aleesposito85/openwindow/docs/plans/2026-10-11-soft-edges.md

# OpenWindow Soft Edges Implementation Plan

> **For agentic workers:** REQUIRED SUB-SKILL: Use superpowers:subagent-driven-development (recommended) or superpowers:executing-plans to implement this plan task-by-task. Steps use checkbox (`- [ ]`) syntax for tracking.

**Goal:** Round every printed profile's outside edges to 2 mm, bevel every joint by 0.8 mm, and soften the hand-touched parts. Seals, glazing, tubes, joints and fixings keep their exact shape.

**Architecture:**
- **Profile rounding.**
  - `cad/profile.scad` builds each profile from a list of base rectangles (or the sill polygon). It rounds them with `soften()` (shrink by `EDGE_R`, grow back with radius `EDGE_R`) before subtracting any functional cut.
  - A short per-profile table, `sharp_corners()`, adds back the corners where a cut ends too close to keep a 1.5 mm wall.
  - A new CAD test finds every convex corner automatically, samples its 2 mm arc and checks the distance to every cut, so the table can't go stale.
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
