aleesposito85/openwindow/docs/img/deck/corner.png

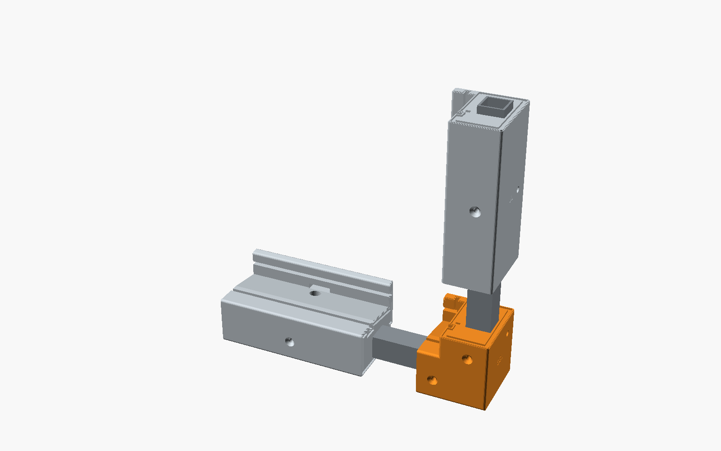
docs/img/deck/corner.png
