aleesposito85/openwindow/docs/img/deck/hero-bench.png

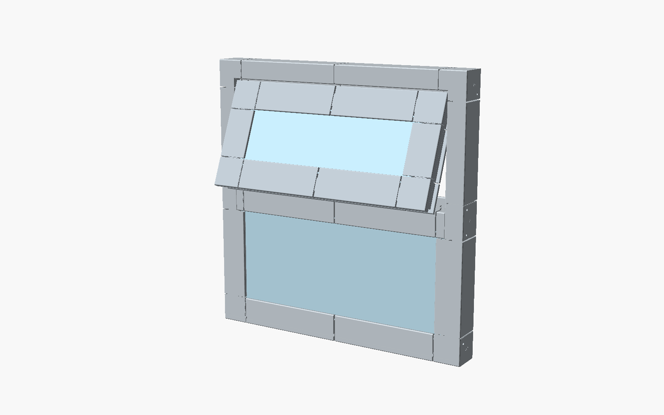
docs/img/deck/hero-bench.png
