aleesposito85/openwindow/docs/img/deck/hinge.png

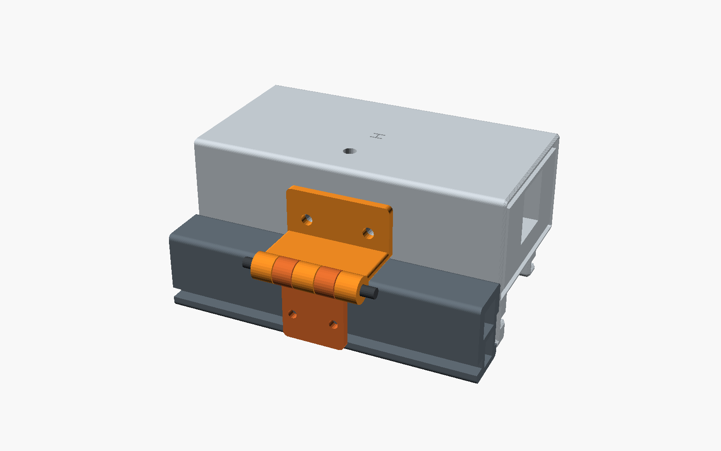
docs/img/deck/hinge.png
