aleesposito85/openwindow/docs/img/deck/inside-open.png

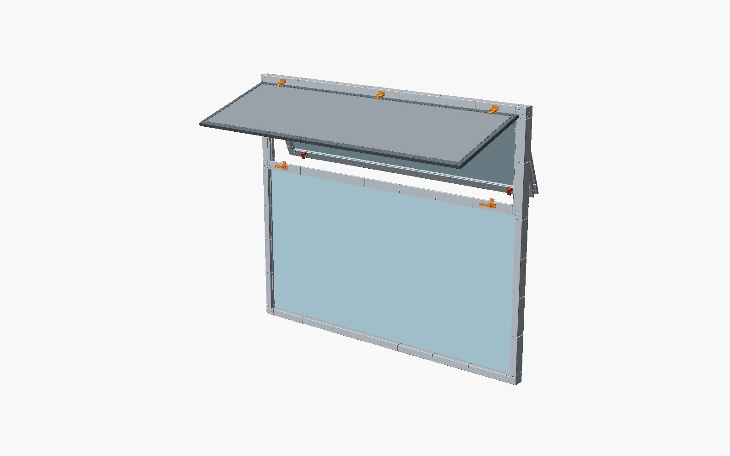
docs/img/deck/inside-open.png
