aleesposito85/openwindow/docs/img/deck/joint.png

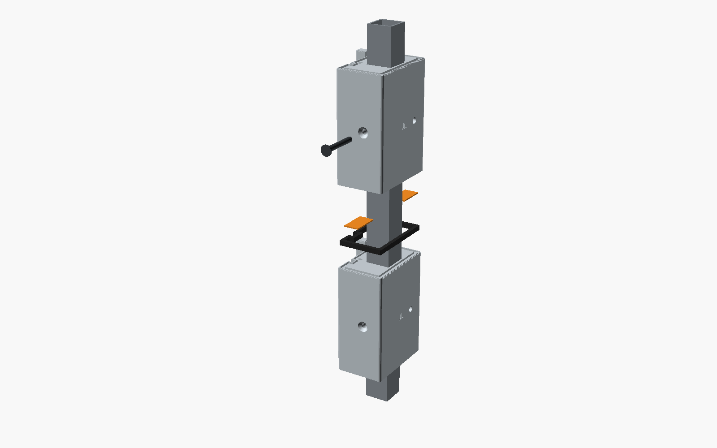
docs/img/deck/joint.png
