aleesposito85/openwindow/docs/img/deck/node.png

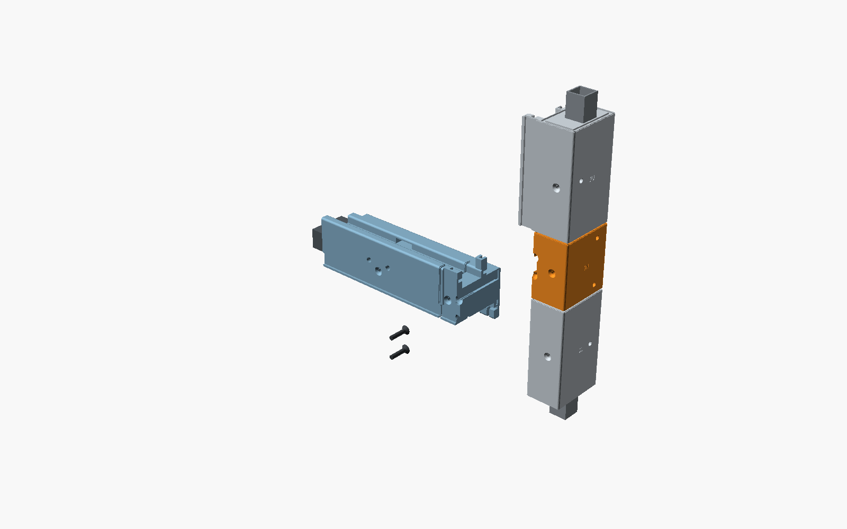
docs/img/deck/node.png
