aleesposito85/openwindow/docs/img/deck/part-AC.png

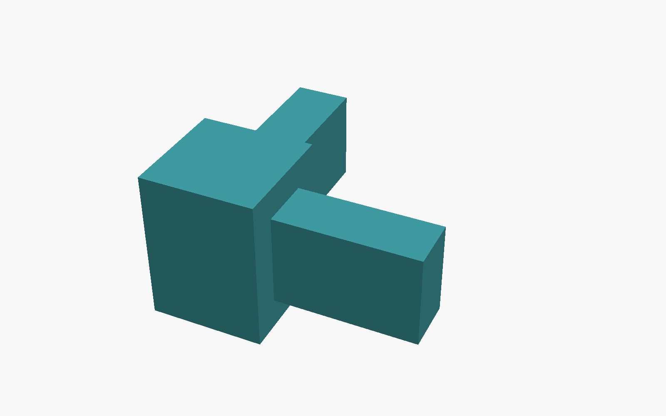
docs/img/deck/part-AC.png
