aleesposito85/openwindow/docs/img/deck/part-AFH.png

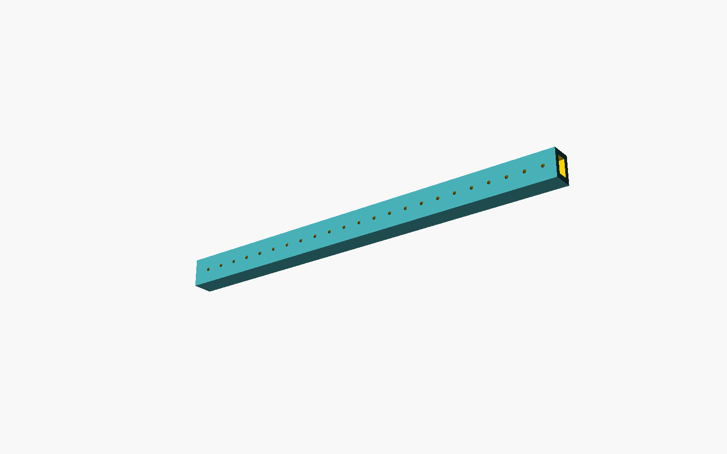
docs/img/deck/part-AFH.png
