aleesposito85/openwindow/docs/img/deck/part-CH.png

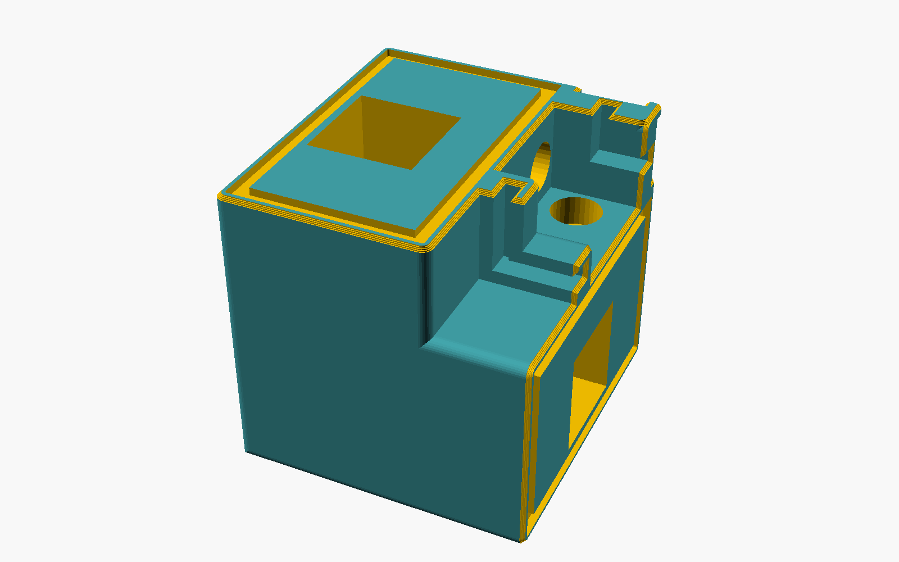
docs/img/deck/part-CH.png
