aleesposito85/openwindow/docs/img/deck/part-CMB.png

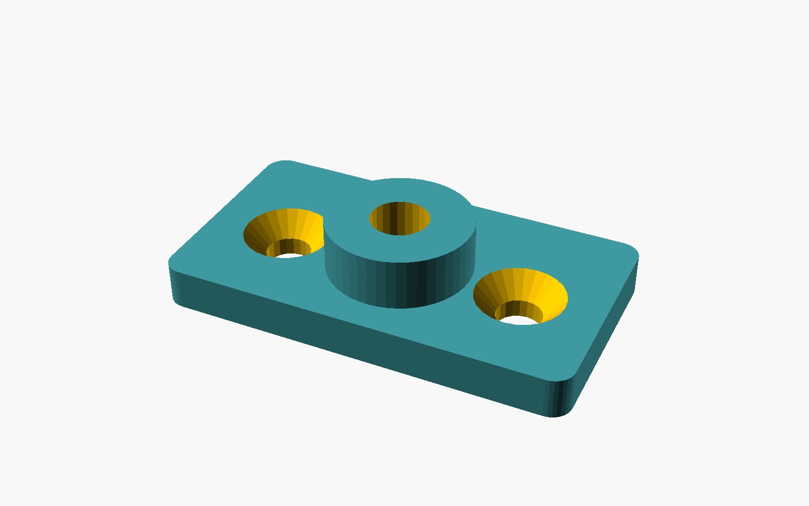
docs/img/deck/part-CMB.png
