aleesposito85/openwindow/docs/img/deck/part-CMH.png

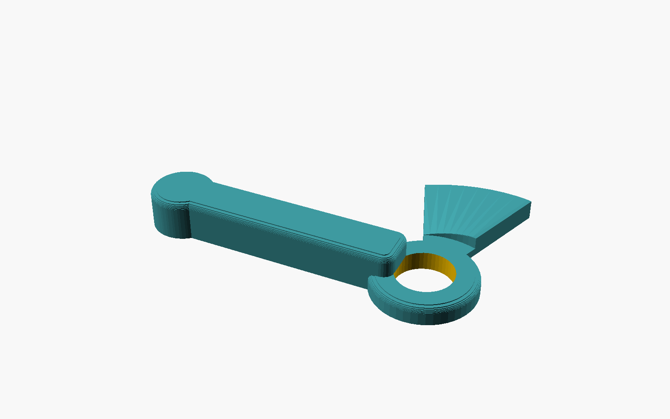
docs/img/deck/part-CMH.png
