aleesposito85/openwindow/docs/img/deck/part-CN.png

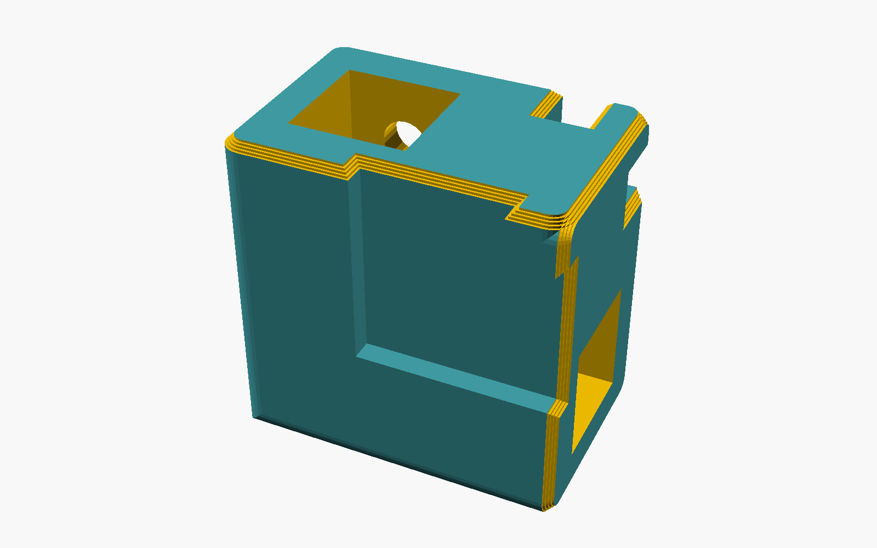
docs/img/deck/part-CN.png
