aleesposito85/openwindow/docs/img/deck/part-CS.png

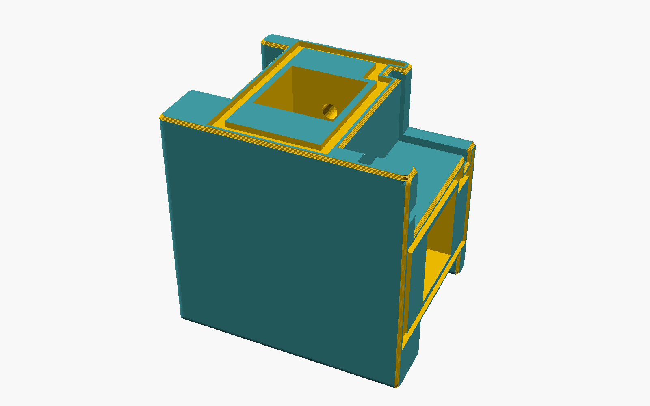
docs/img/deck/part-CS.png
