aleesposito85/openwindow/docs/img/deck/part-CSR.png

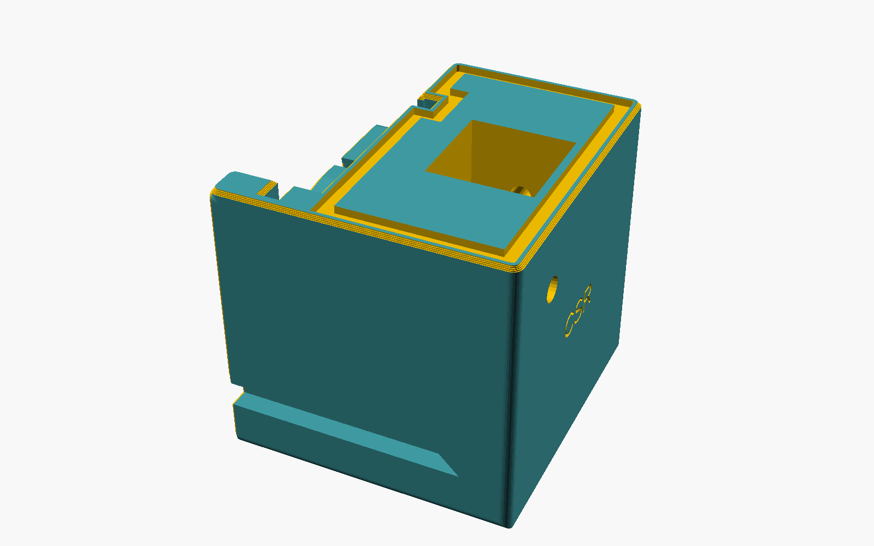
docs/img/deck/part-CSR.png
