aleesposito85/openwindow/docs/img/deck/part-GF.png

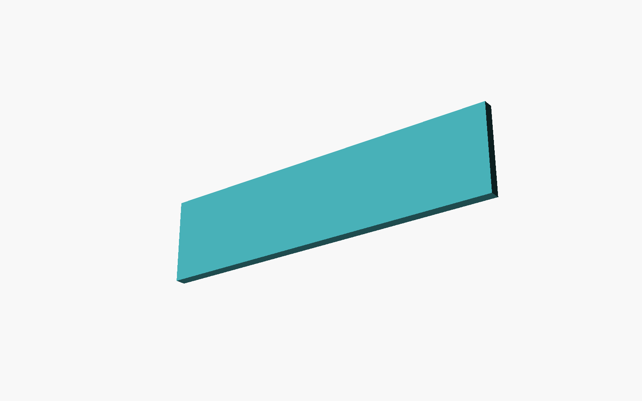
docs/img/deck/part-GF.png
