aleesposito85/openwindow/docs/img/deck/part-H.png

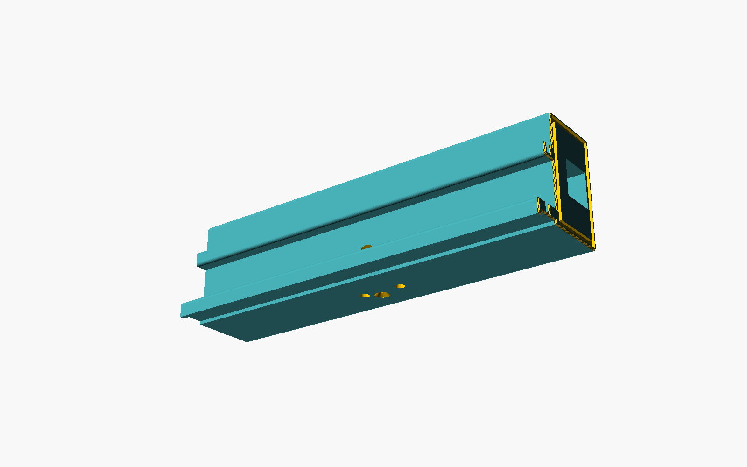
docs/img/deck/part-H.png
