aleesposito85/openwindow/docs/img/deck/part-HG.png

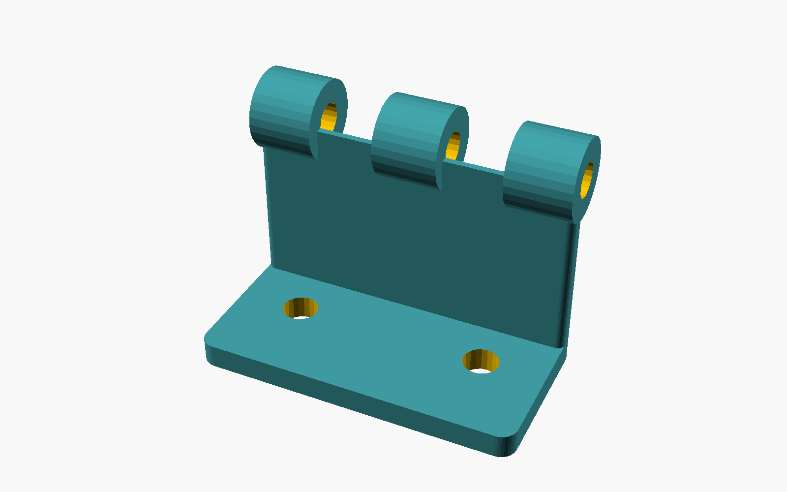
docs/img/deck/part-HG.png
