aleesposito85/openwindow/docs/img/deck/part-HS.png

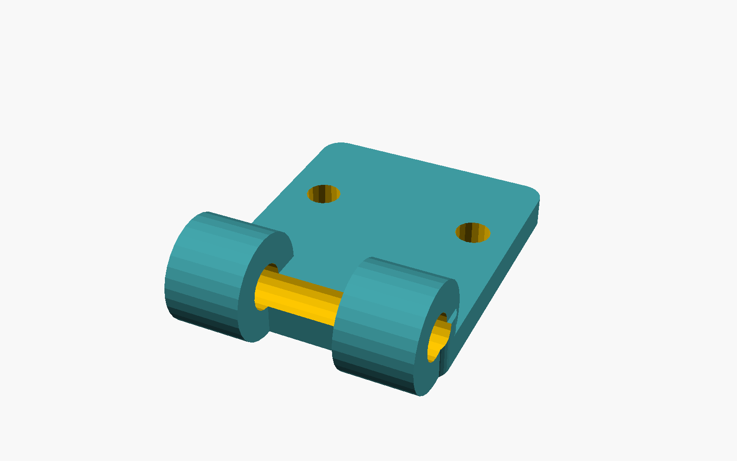
docs/img/deck/part-HS.png
