aleesposito85/openwindow/docs/img/deck/part-JN.png

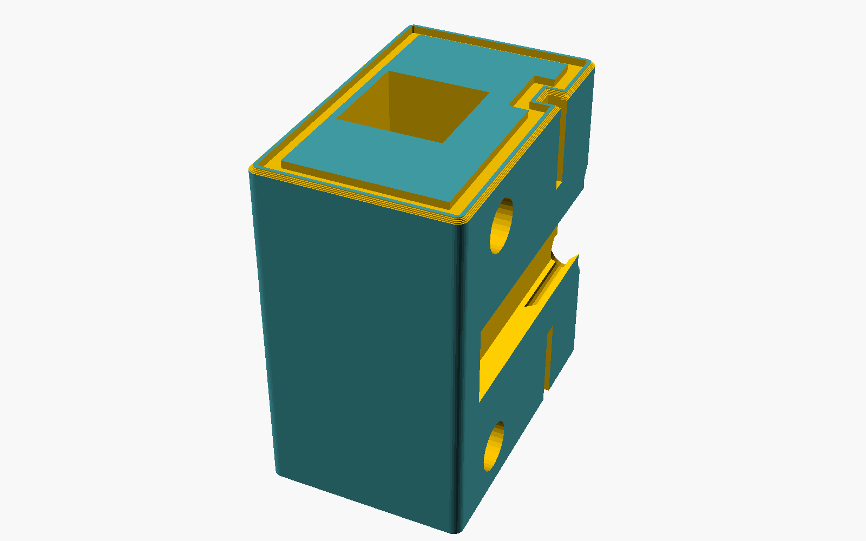
docs/img/deck/part-JN.png
