aleesposito85/openwindow/docs/img/deck/part-KP.png

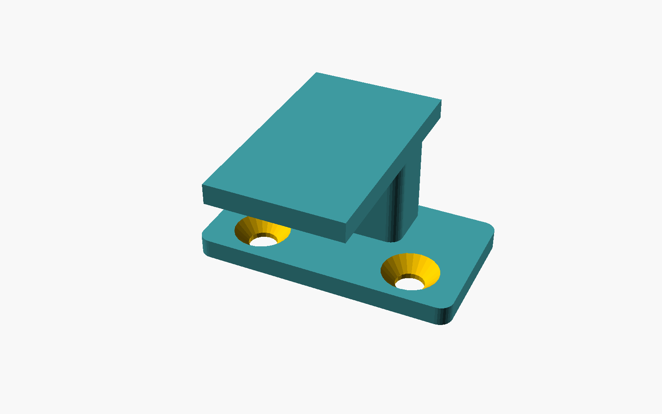
docs/img/deck/part-KP.png
