aleesposito85/openwindow/docs/img/deck/part-TC.png

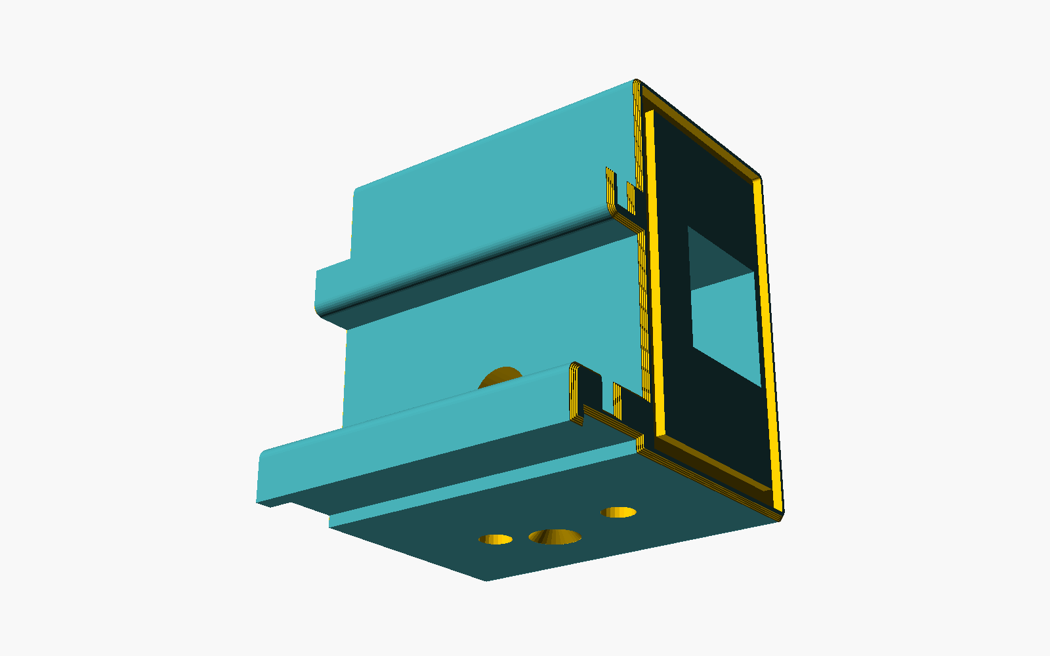
docs/img/deck/part-TC.png
