aleesposito85/openwindow/docs/img/deck/part-TSL.png

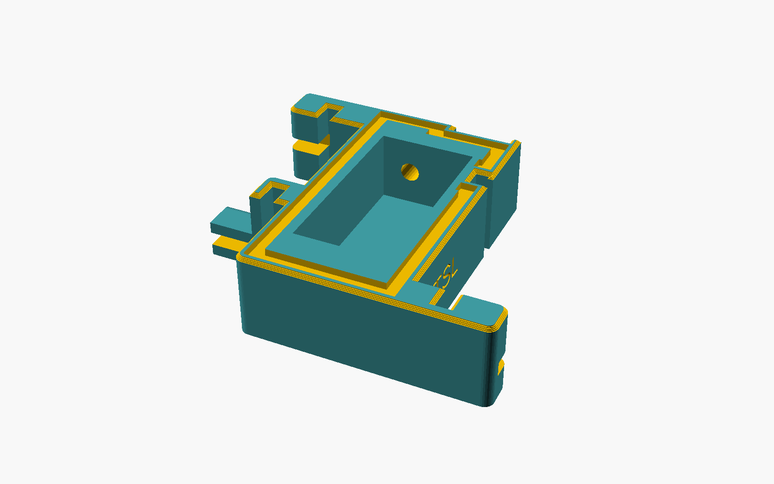
docs/img/deck/part-TSL.png
