aleesposito85/openwindow/docs/img/deck/part-TSR.png

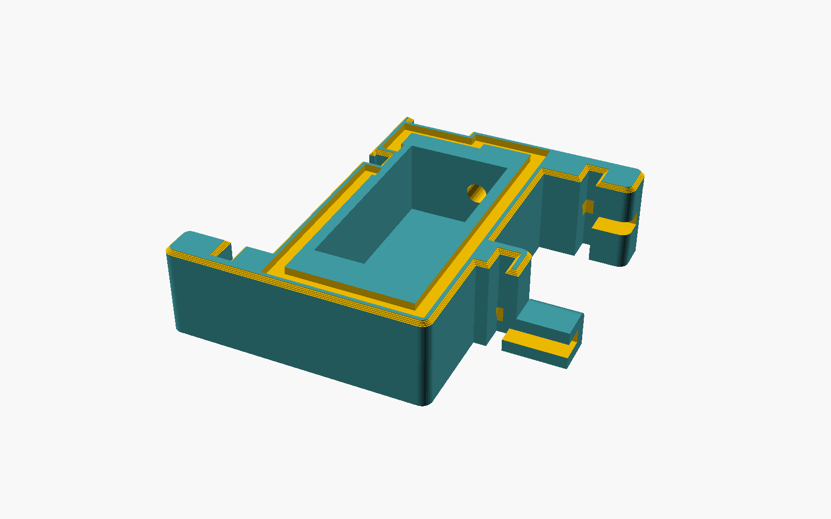
docs/img/deck/part-TSR.png
