aleesposito85/openwindow/docs/img/deck/profile-0.png

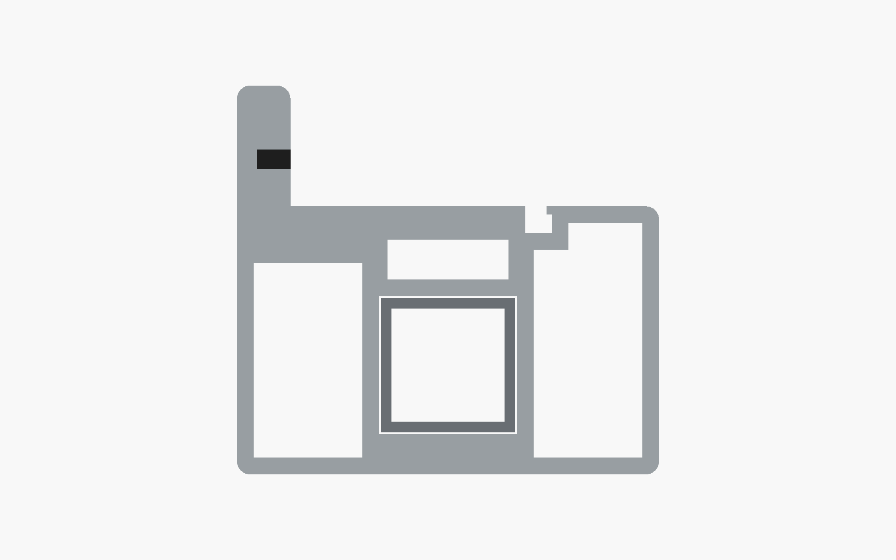
docs/img/deck/profile-0.png
