aleesposito85/openwindow/docs/img/deck/profile-1.png

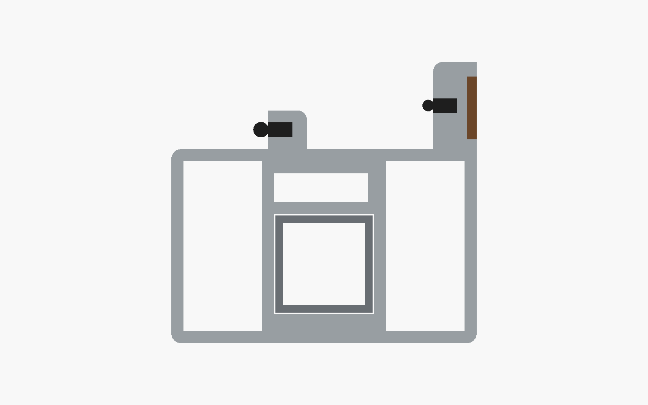
docs/img/deck/profile-1.png
