aleesposito85/openwindow/docs/img/deck/profile-2.png

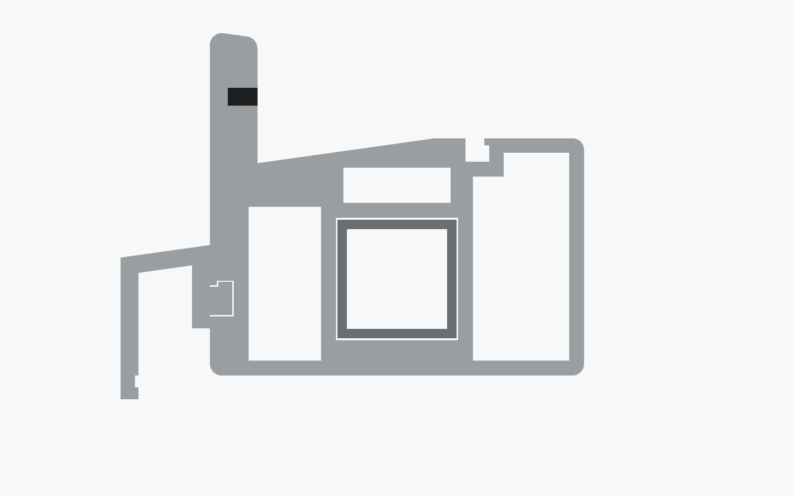
docs/img/deck/profile-2.png
