aleesposito85/openwindow/docs/img/deck/profile-3.png

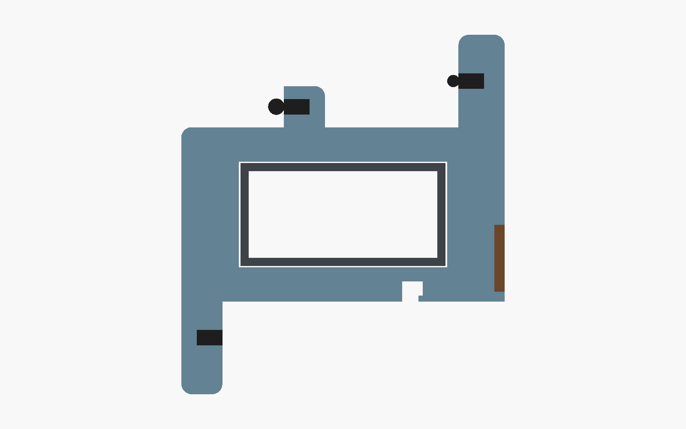
docs/img/deck/profile-3.png
