aleesposito85/openwindow/docs/img/deck/profile-4.png

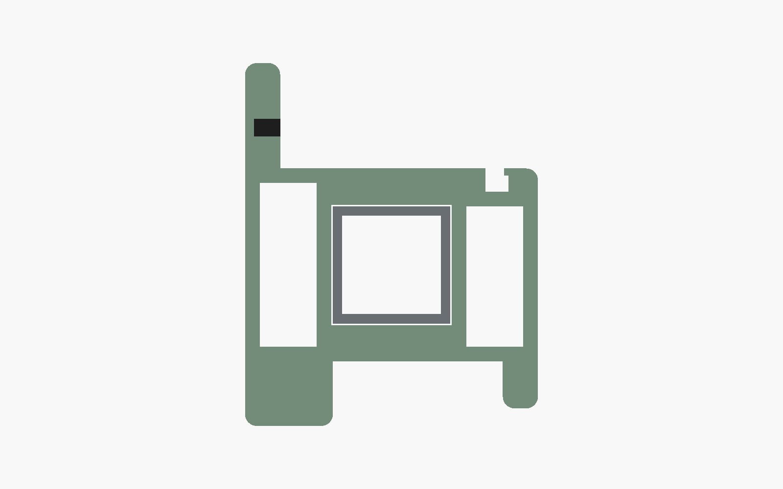
docs/img/deck/profile-4.png
