aleesposito85/openwindow/docs/img/deck/profile-5.png

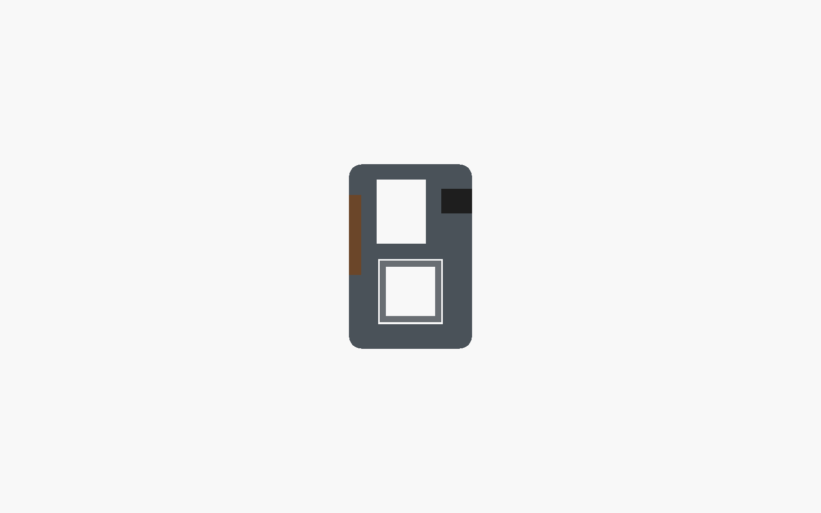
docs/img/deck/profile-5.png
