aleesposito85/openwindow/docs/img/deck/profile-6.png

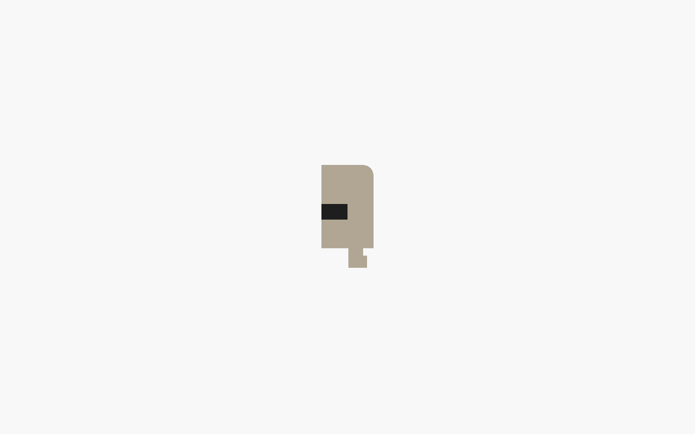
docs/img/deck/profile-6.png
