aleesposito85/openwindow/docs/img/deck/section-0.png

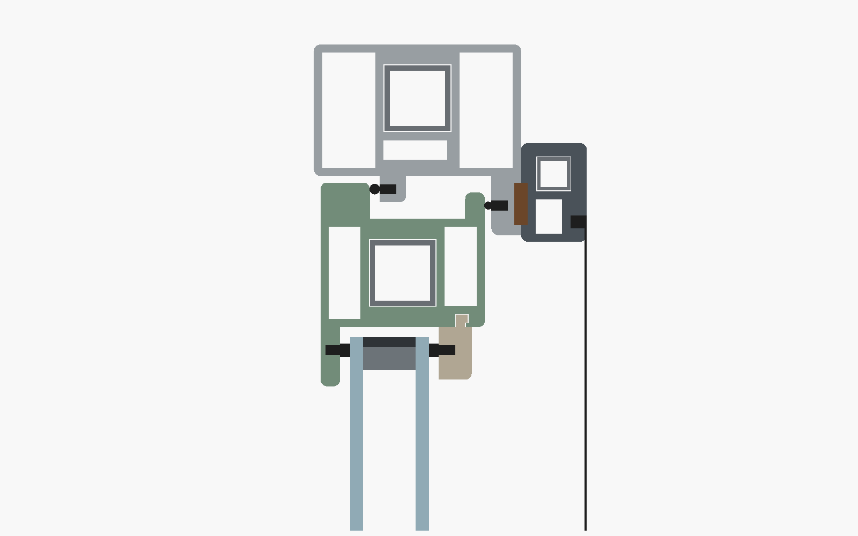
docs/img/deck/section-0.png
