aleesposito85/openwindow/docs/img/deck/section-2.png

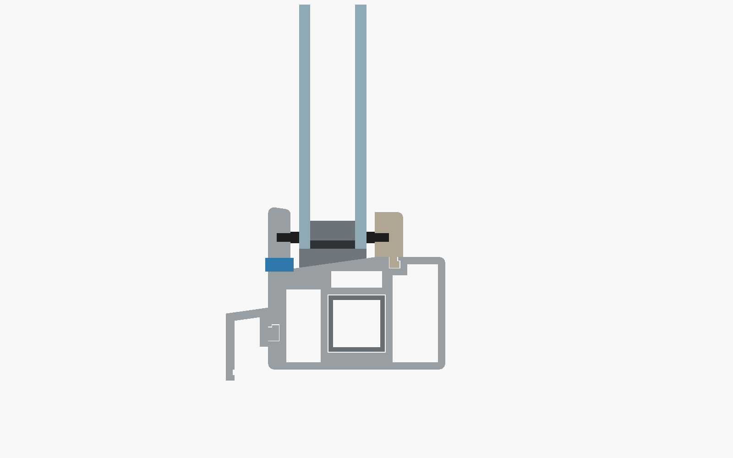
docs/img/deck/section-2.png
