aleesposito85/openwindow/docs/img/deck/section-3.png

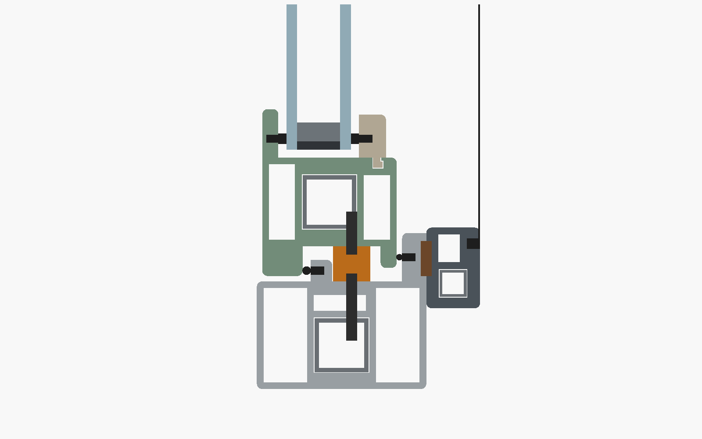
docs/img/deck/section-3.png
