aleesposito85/openwindow/docs/img/deck/sill-detail.png

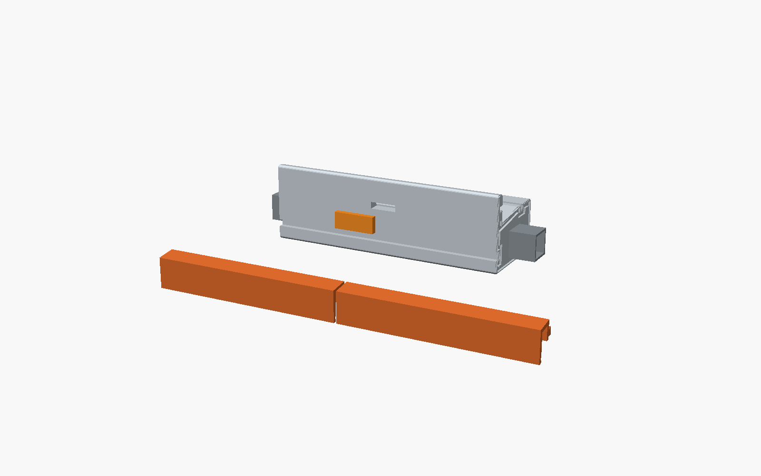
docs/img/deck/sill-detail.png
