aleesposito85/openwindow/docs/img/deck/unit-0.png

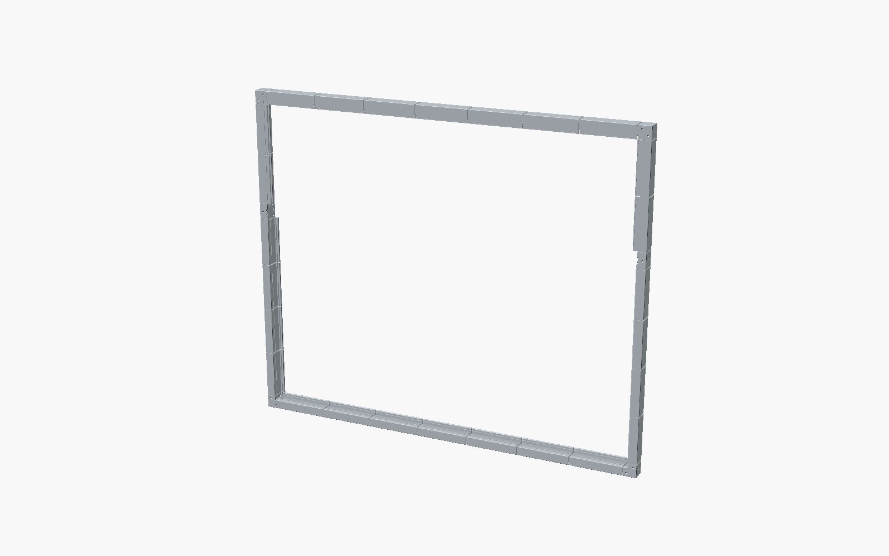
docs/img/deck/unit-0.png
