aleesposito85/openwindow/docs/img/deck/unit-1.png

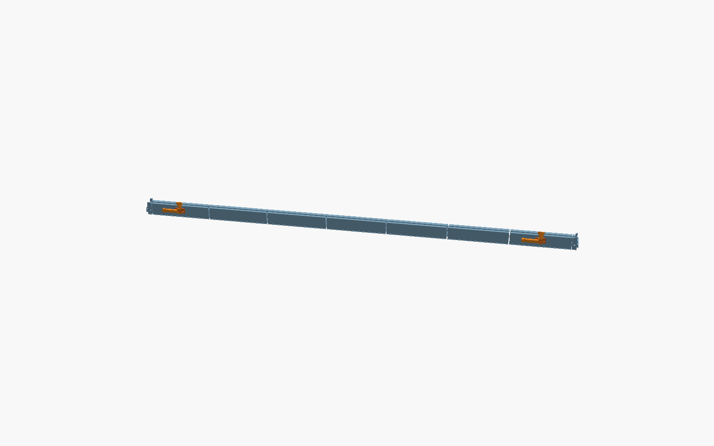
docs/img/deck/unit-1.png
