aleesposito85/openwindow/docs/img/deck/unit-2.png

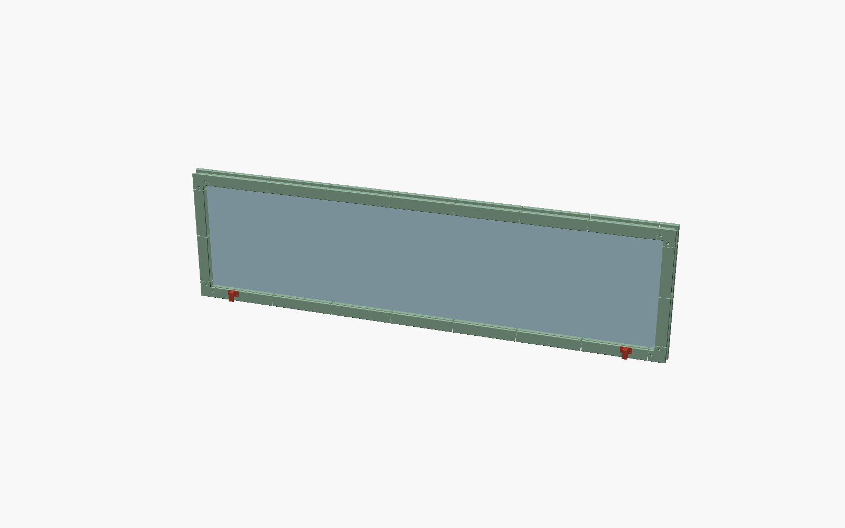
docs/img/deck/unit-2.png
