aleesposito85/openwindow/docs/img/deck/unit-4.png

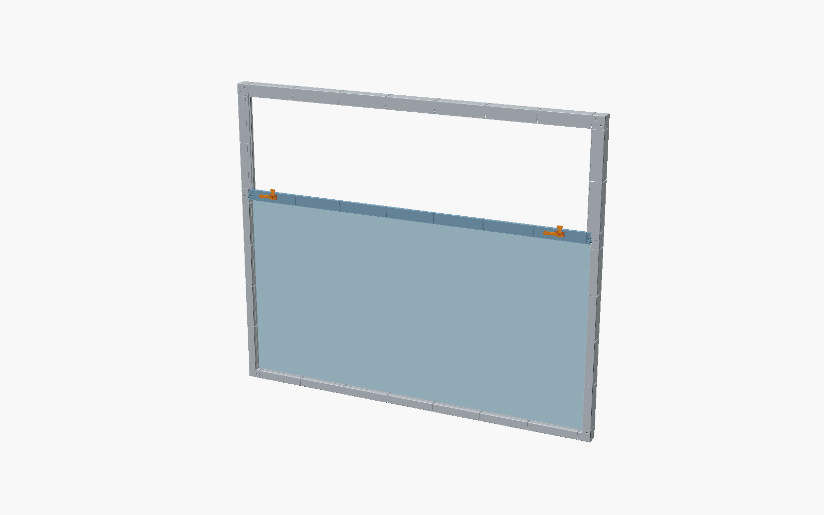
docs/img/deck/unit-4.png
