aleesposito85/openwindow/docs/img/fit_view.png

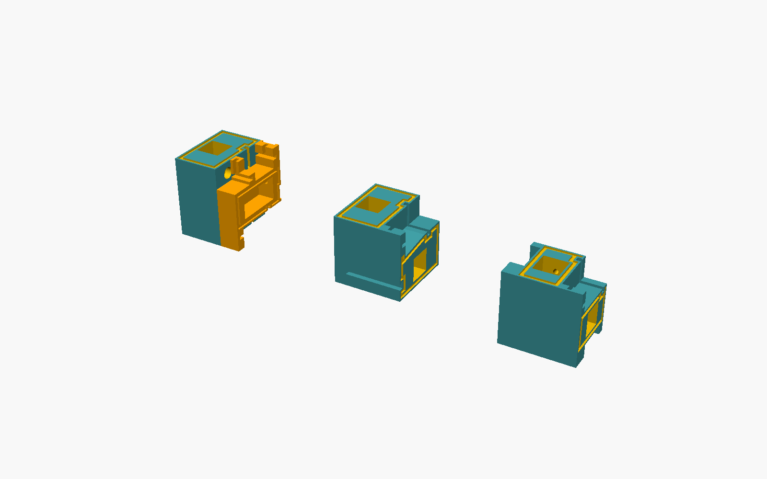
docs/img/fit_view.png
