aleesposito85/openwindow/docs/img/lock_view.png

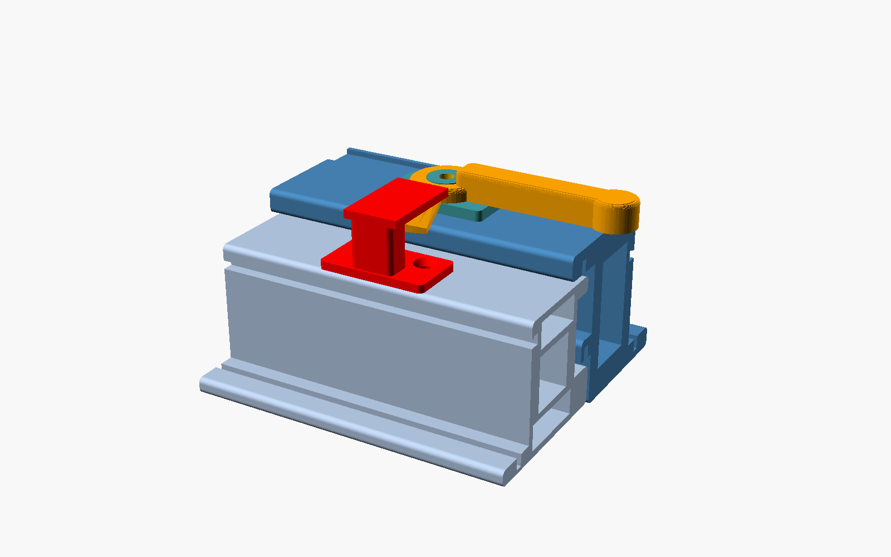
docs/img/lock_view.png
