aleesposito85/openwindow/docs/img/section-home.png

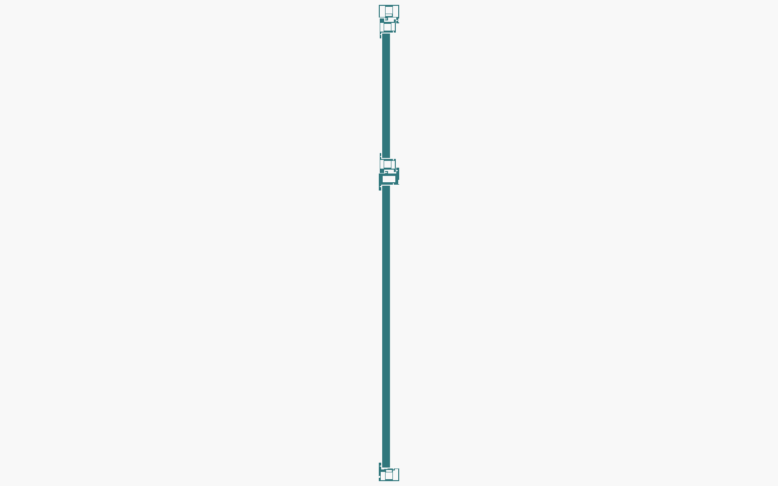
docs/img/section-home.png
