aleesposito85/openwindow/bom/home-1800x1500.md

# BOM: home-1800x1500

Prints: 160 parts in 35 types (list: `bom/home-1800x1500-parts.csv`).

| Group | Item | Qty | Unit |
|---|---|---|---|
| Fixings | Timber screw 10g x 75, stainless or galvanised (frame fixings) | 38 | pcs |
| Fixings | Self-tapping screw 8g x 30 stainless, countersunk (aluminium tube screws: frame, sash, corners, nodes) | 62 | pcs |
| Fixings | Tek screw 8g x 25, 410 stainless, countersunk (steel transom tube: T, TE, shoes) | 9 | pcs |
| Fixings | Self-tapping screw 8g x 12 stainless, countersunk (screen tube screws) | 26 | pcs |
| Fixings | M4 heat-set insert for a 5.6 x 8 mm hole | 30 | pcs |
| Fixings | M4 x 10 countersunk machine screw (cam bases CMB, keepers KP) | 8 | pcs |
| Fixings | M4 x 10 pan or button head machine screw (hinge frame leaves HG) | 6 | pcs |
| Fixings | M4 x 8 pan screw + 20 mm penny washer (cam pivots) | 2 | pcs |
| Fixings | M4 x 16 countersunk machine screw (transom lock screws) | 4 | pcs |
| Fixings | M4 x 50 bolt + nyloc nut (hinge pins) | 3 | pcs |
| Fixings | 4g x 12 self-tapping screw (screen leaves HS) | 6 | pcs |
| Fixings | Plastic window packers, assorted 1-10 mm (one stack per position) | 44 | pcs |
| Hardware | Stainless friction stay pair, 400 mm, stack <= 13 mm, track/arm width <= 14 mm (check rating >= 15.7 kg) | 1 | pair |
| Hardware | Friction-stay screw 8g x 25 stainless, countersunk (tracks to upper jambs; match the stay's holes) | 8 | pcs |
| Hardware | Friction-stay screw 8g x 16 stainless, countersunk (arms to sash sides; match the stay's holes) | 6 | pcs |
| Seals | EPDM bulb kerf seal, 3 mm kerf (outer + inner loop round the sash opening) | 8.92 | m |
| Seals | EPDM glazing wedge gasket, 3 mm | 18.28 | m |
| Seals | Closed-cell foam cord, 4 mm (one ring per segment joint) | 11.3 | m |
| Seals | Closed-cell foam cord, 3 mm (transom shoe seams) | 0.14 | m |
| Seals | MS-polymer sealant rated for +/-50% joint movement (ASTM C920 Class 50 or equal), 290 ml cartridge (joints, fixing bedding, outside perimeter) | 3 | pcs |
| Seals | Butyl flashing tape, 150 mm wide (sill tray; or two 100 mm runs lapped 50 mm) | 2.08 | m |
| Seals | Backer rod, 10 mm | 6.54 | m |
| Seals | Low-expansion window foam, can | 1 | pcs |
| Seals | Gel CA glue (EPDM loop joints) | 1 | pcs |
| Screen | Flexible magnetic strip A, 12.7 mm, adhesive-backed (screen back channel) | 4.53 | m |
| Screen | Flexible magnetic strip B, 12.7 mm, adhesive-backed, matched to A, or adhesive steel strip (frame magnet channel) | 4.53 | m |
| Screen | Fibreglass insect mesh | 1.02 | m2 |
| Screen | Screen spline, 4 mm | 4.53 | m |
| Screen | Two-part epoxy, 5-minute (screen corner joints) | 1 | pcs |
| Tube | Tube alu10 (total length; buy in 1 m/3 m stock) | 4.37 | m |
| Tube | Tube alu20 (total length; buy in 1 m/3 m stock) | 10.31 | m |
| Tube | Tube steel40x20 (total length; buy in 1 m/3 m stock) | 1.7 | m |
| Glazing | IGU 4/16/4 = 24 mm, toughened if required by AS 1288, low-E/argon optional, 1698 x 878 (fixed pane) | 1 | pcs |
| Glazing | IGU 4/16/4 = 24 mm, toughened if required by AS 1288, low-E/argon optional, 1606 x 388 (sash pane) | 1 | pcs |
| Filament | PETG (interior) | 3.84 | kg |
| Filament | ASA-CF or PC-ABS (light colour) (exterior, tier 3) | 16.36 | kg |

## Tube cut list (`bom/home-1800x1500-cutlist.csv`)

| Member | Core | Length (mm) | Qty |
|---|---|---|---|
| head | alu20 | 1721.0 | 1 |
| sill | alu20 | 1721.0 | 1 |
| jamb | alu20 | 1421.0 | 2 |
| transom | steel40x20 | 1696.0 | 1 |
| sash_horizontal | alu20 | 1615.0 | 2 |
| sash_vertical | alu20 | 397.0 | 2 |
| screen_horizontal | alu10 | 1685.0 | 2 |
| screen_vertical | alu10 | 501.0 | 2 |

## Glass (`bom/home-1800x1500-glass.csv`)

| Pane | Glazing | Width (mm) | Height (mm) | Qty |
|---|---|---|---|---|
| fixed | igu | 1698 | 878 | 1 |
| sash | igu | 1606 | 388 | 1 |
