aleesposito85/openwindow/bom/bench-600-parts.csv

id | qty | role | length | module | call
H | 2 | exterior | 232.5 | frame_segment | frame_segment("sash_rebate", 232.5, "H", bosses=true);
SW | 2 | exterior | 232.5 | frame_segment | frame_segment("sill", 232.5, "SW", weep=true);
JL | 2 | exterior | 196.0 | frame_segment | frame_segment("glazing", 196.0, "JL");
JU | 2 | exterior | 198.0 | frame_segment | frame_segment("sash_rebate", 198.0, "JU");
TE | 2 | exterior | 232.5 | frame_segment | frame_segment("transom", 232.5, "TE", weep=true, bosses=true);
SH | 2 | exterior | 186.5 | frame_segment | frame_segment("sash", 186.5, "SH");
SBE | 2 | exterior | 186.5 | frame_segment | frame_segment("sash", 186.5, "SBE", weep=true, bosses=true, boss_dz=23.0);
SV | 2 | exterior | 106.0 | frame_segment | frame_segment("sash", 106.0, "SV");
NH | 4 | interior | 232.0 | frame_segment | frame_segment("screen", 232.0, "NH");
NV | 2 | interior | 230.0 | frame_segment | frame_segment("screen", 230.0, "NV");
CH | 2 | exterior |  | corner_block | corner_block("sash_rebate", "sash_rebate", "CH");
CSL | 1 | exterior |  | corner_block | corner_block("sill", "glazing", "CSL");
CSR | 1 | exterior |  | corner_block | corner_block("sill", "glazing", "CSR", mirrored=true);
CS | 4 | exterior |  | corner_block | corner_block("sash", "sash", "CS");
CN | 4 | interior |  | corner_block | corner_block("screen", "screen", "CN");
JN | 2 | exterior |  | jamb_node | jamb_node("JN");
TSL | 1 | exterior |  | transom_shoe | transom_shoe("TSL", mirrored=true);
TSR | 1 | exterior |  | transom_shoe | transom_shoe("TSR");
GW | 2 | exterior |  | setting_block | setting_block("GW", wedge=true);
GF | 6 | exterior |  | setting_block | setting_block("GF");
WC | 4 | exterior |  | weep_cap | weep_cap("WC");
NS | 3 | exterior | 182.67 | sill_nose | sill_nose(182.67, "NS");
CMB | 2 | interior |  | cam_base | cam_base("CMB");
CMH | 2 | interior |  | cam_handle | cam_handle("CMH");
KP | 2 | interior |  | cam_keeper | cam_keeper("KP");
HG | 2 | interior |  | screen_hinge | screen_hinge("HG");
HS | 2 | interior |  | screen_leaf | screen_leaf("HS");
TC | 1 | exterior |  | test_coupon | test_coupon("TC");
BFH | 6 | interior | 168.0 | bead | bead("acrylic", 168.0, "BFH");
BFV | 2 | interior | 202.0 | bead | bead("acrylic", 202.0, "BFV");
BSH | 4 | interior | 206.0 | bead | bead("acrylic", 206.0, "BSH");
BSV | 2 | interior | 112.0 | bead | bead("acrylic", 112.0, "BSV");
AFH | 4 | exterior | 237.0 | acrylic_spacer | acrylic_spacer(237.0, "AFH");
AFV | 2 | exterior | 204.0 | acrylic_spacer | acrylic_spacer(204.0, "AFV");
ASH | 4 | exterior | 191.0 | acrylic_spacer | acrylic_spacer(191.0, "ASH");
ASV | 2 | exterior | 114.0 | acrylic_spacer | acrylic_spacer(114.0, "ASV");
AC | 8 | exterior |  | acrylic_spacer_corner | acrylic_spacer_corner("AC");
