aleesposito85/openwindow/bom/home-1800x1500-2bay-parts.csv

id | qty | role | length | module | call
H | 8 | exterior | 198.5 | frame_segment | frame_segment("sash_rebate", 198.5, "H", bosses=true);
S | 4 | exterior | 198.5 | frame_segment | frame_segment("sill", 198.5, "S");
SW | 4 | exterior | 198.5 | frame_segment | frame_segment("sill", 198.5, "SW", weep=true);
JL | 8 | exterior | 210.75 | frame_segment | frame_segment("glazing", 210.75, "JL");
JU | 4 | exterior | 223.5 | frame_segment | frame_segment("sash_rebate", 223.5, "JU");
T | 4 | exterior | 198.5 | frame_segment | frame_segment("transom", 198.5, "T");
TE | 4 | exterior | 198.5 | frame_segment | frame_segment("transom", 198.5, "TE", weep=true, bosses=true);
ML | 4 | exterior | 210.75 | frame_segment | frame_segment("mullion_glazing", 210.75, "ML");
MU | 2 | exterior | 223.5 | frame_segment | frame_segment("mullion_sash", 223.5, "MU");
SH | 6 | exterior | 234.33 | frame_segment | frame_segment("sash", 234.33, "SH");
SB | 2 | exterior | 234.33 | frame_segment | frame_segment("sash", 234.33, "SB");
SBE | 4 | exterior | 234.33 | frame_segment | frame_segment("sash", 234.33, "SBE", weep=true, bosses=true, boss_dz=63.92);
SV | 8 | exterior | 177.5 | frame_segment | frame_segment("sash", 177.5, "SV");
NH | 16 | interior | 198.75 | frame_segment | frame_segment("screen", 198.75, "NH");
NV | 8 | interior | 240.0 | frame_segment | frame_segment("screen", 240.0, "NV");
CH | 2 | exterior |  | corner_block | corner_block("sash_rebate", "sash_rebate", "CH");
CSL | 1 | exterior |  | corner_block | corner_block("sill", "glazing", "CSL");
CSR | 1 | exterior |  | corner_block | corner_block("sill", "glazing", "CSR", mirrored=true);
CS | 8 | exterior |  | corner_block | corner_block("sash", "sash", "CS");
CN | 8 | interior |  | corner_block | corner_block("screen", "screen", "CN");
JN | 2 | exterior |  | jamb_node | jamb_node("JN");
TSL | 1 | exterior |  | transom_shoe | transom_shoe("TSL", mirrored=true);
TSR | 1 | exterior |  | transom_shoe | transom_shoe("TSR");
SN | 1 | exterior |  | frame_node | frame_node("sill", "SN");
HN | 1 | exterior |  | frame_node | frame_node("sash_rebate", "HN");
TX | 1 | exterior |  | cross_node | cross_node("TX");
MSL | 2 | exterior |  | mullion_shoe | mullion_shoe("mullion_glazing", "MSL");
MST | 1 | exterior |  | mullion_shoe | mullion_shoe("mullion_sash", "MST");
MSH | 1 | exterior |  | mullion_shoe | mullion_shoe("mullion_sash", "MSH", head=true);
GW | 4 | exterior |  | setting_block | setting_block("GW", wedge=true);
GF | 12 | exterior |  | setting_block | setting_block("GF");
WC | 8 | exterior |  | weep_cap | weep_cap("WC");
NS | 8 | exterior | 217.88 | sill_nose | sill_nose(217.88, "NS");
CMB | 4 | interior |  | cam_base | cam_base("CMB");
CMH | 4 | interior |  | cam_handle | cam_handle("CMH");
KP | 4 | interior |  | cam_keeper | cam_keeper("KP");
HG | 4 | interior |  | screen_hinge | screen_hinge("HG");
HS | 4 | interior |  | screen_leaf | screen_leaf("HS");
TC | 1 | exterior |  | test_coupon | test_coupon("TC");
BFH | 16 | interior | 208.75 | bead | bead("igu", 208.75, "BFH");
BFV | 16 | interior | 213.0 | bead | bead("igu", 213.0, "BFV");
BSH | 16 | interior | 185.75 | bead | bead("igu", 185.75, "BSH");
BSV | 8 | interior | 181.0 | bead | bead("igu", 181.0, "BSV");
