aleesposito85/openwindow/bom/home-1800x1500-parts.csv

id | qty | role | length | module | call
H | 7 | exterior | 237.14 | frame_segment | frame_segment("sash_rebate", 237.14, "H", bosses=true);
S | 5 | exterior | 237.14 | frame_segment | frame_segment("sill", 237.14, "S");
SW | 2 | exterior | 237.14 | frame_segment | frame_segment("sill", 237.14, "SW", weep=true);
JL | 8 | exterior | 210.75 | frame_segment | frame_segment("glazing", 210.75, "JL");
JU | 4 | exterior | 223.5 | frame_segment | frame_segment("sash_rebate", 223.5, "JU");
T | 5 | exterior | 237.14 | frame_segment | frame_segment("transom", 237.14, "T");
TE | 2 | exterior | 237.14 | frame_segment | frame_segment("transom", 237.14, "TE", weep=true, bosses=true);
SH | 7 | exterior | 224.0 | frame_segment | frame_segment("sash", 224.0, "SH");
SB | 5 | exterior | 224.0 | frame_segment | frame_segment("sash", 224.0, "SB");
SBE | 2 | exterior | 224.0 | frame_segment | frame_segment("sash", 224.0, "SBE", weep=true, bosses=true, boss_dz=39.43);
SV | 4 | exterior | 177.5 | frame_segment | frame_segment("sash", 177.5, "SV");
NH | 14 | interior | 237.71 | frame_segment | frame_segment("screen", 237.71, "NH");
NV | 4 | interior | 240.0 | frame_segment | frame_segment("screen", 240.0, "NV");
CH | 2 | exterior |  | corner_block | corner_block("sash_rebate", "sash_rebate", "CH");
CSL | 1 | exterior |  | corner_block | corner_block("sill", "glazing", "CSL");
CSR | 1 | exterior |  | corner_block | corner_block("sill", "glazing", "CSR", mirrored=true);
CS | 4 | exterior |  | corner_block | corner_block("sash", "sash", "CS");
CN | 4 | interior |  | corner_block | corner_block("screen", "screen", "CN");
JN | 2 | exterior |  | jamb_node | jamb_node("JN");
TSL | 1 | exterior |  | transom_shoe | transom_shoe("TSL", mirrored=true);
TSR | 1 | exterior |  | transom_shoe | transom_shoe("TSR");
GW | 2 | exterior |  | setting_block | setting_block("GW", wedge=true);
GF | 6 | exterior |  | setting_block | setting_block("GF");
WC | 4 | exterior |  | weep_cap | weep_cap("WC");
NS | 8 | exterior | 217.88 | sill_nose | sill_nose(217.88, "NS");
CMB | 2 | interior |  | cam_base | cam_base("CMB");
CMH | 2 | interior |  | cam_handle | cam_handle("CMH");
KP | 2 | interior |  | cam_keeper | cam_keeper("KP");
HG | 3 | interior |  | screen_hinge | screen_hinge("HG");
HS | 3 | interior |  | screen_leaf | screen_leaf("HS");
TC | 1 | exterior |  | test_coupon | test_coupon("TC");
BFH | 16 | interior | 213.0 | bead | bead("igu", 213.0, "BFH");
BFV | 8 | interior | 213.0 | bead | bead("igu", 213.0, "BFV");
BSH | 14 | interior | 230.29 | bead | bead("igu", 230.29, "BSH");
BSV | 4 | interior | 181.0 | bead | bead("igu", 181.0, "BSV");
