aleesposito85/openwindow/bom/my-window-parts.csv

id | qty | role | length | module | call
H | 8 | exterior | 198.5 | frame_segment | frame_segment("sash_rebate", 198.5, "H", bosses=true, core="vslot");
S | 4 | exterior | 198.5 | frame_segment | frame_segment("sill", 198.5, "S", core="vslot");
SW | 4 | exterior | 198.5 | frame_segment | frame_segment("sill", 198.5, "SW", weep=true, core="vslot");
JL | 8 | exterior | 210.75 | frame_segment | frame_segment("glazing", 210.75, "JL", core="vslot");
JU | 4 | exterior | 223.5 | frame_segment | frame_segment("sash_rebate", 223.5, "JU", core="vslot");
T | 4 | exterior | 198.5 | frame_segment | frame_segment("transom", 198.5, "T");
TE | 4 | exterior | 198.5 | frame_segment | frame_segment("transom", 198.5, "TE", weep=true, bosses=true);
ML | 4 | exterior | 210.75 | frame_segment | frame_segment("mullion_glazing", 210.75, "ML", core="vslot");
MU | 2 | exterior | 223.5 | frame_segment | frame_segment("mullion_sash", 223.5, "MU", core="vslot");
SH | 6 | exterior | 234.33 | frame_segment | frame_segment("sash", 234.33, "SH", core="vslot");
SB | 2 | exterior | 234.33 | frame_segment | frame_segment("sash", 234.33, "SB", core="vslot");
SBE | 4 | exterior | 234.33 | frame_segment | frame_segment("sash", 234.33, "SBE", weep=true, bosses=true, boss_dz=63.92, core="vslot");
SV | 8 | exterior | 177.5 | frame_segment | frame_segment("sash", 177.5, "SV", core="vslot");
NH | 16 | interior | 198.75 | frame_segment | frame_segment("screen", 198.75, "NH");
NV | 8 | interior | 240.0 | frame_segment | frame_segment("screen", 240.0, "NV");
CH | 2 | exterior |  | corner_block | corner_block("sash_rebate", "sash_rebate", "CH", core_a="vslot", core_b="vslot");
CSL | 1 | exterior |  | corner_block | corner_block("sill", "glazing", "CSL", core_a="vslot", core_b="vslot");
CSR | 1 | exterior |  | corner_block | corner_block("sill", "glazing", "CSR", mirrored=true, core_a="vslot", core_b="vslot");
CS | 8 | exterior |  | corner_block | corner_block("sash", "sash", "CS", core_a="vslot", core_b="vslot");
CN | 8 | interior |  | corner_block | corner_block("screen", "screen", "CN");
JN | 2 | exterior |  | jamb_node | jamb_node("JN", core="vslot");
TSL | 1 | exterior |  | transom_shoe | transom_shoe("TSL", mirrored=true);
TSR | 1 | exterior |  | transom_shoe | transom_shoe("TSR");
SN | 1 | exterior |  | frame_node | frame_node("sill", "SN", core="vslot");
HN | 1 | exterior |  | frame_node | frame_node("sash_rebate", "HN", core="vslot");
TX | 1 | exterior |  | cross_node | cross_node("TX");
MSL | 2 | exterior |  | mullion_shoe | mullion_shoe("mullion_glazing", "MSL", core="vslot");
MST | 1 | exterior |  | mullion_shoe | mullion_shoe("mullion_sash", "MST", core="vslot");
MSH | 1 | exterior |  | mullion_shoe | mullion_shoe("mullion_sash", "MSH", head=true, core="vslot");
GW | 4 | exterior |  | setting_block | setting_block("GW", wedge=true, pane_t=22);
GF | 12 | exterior |  | setting_block | setting_block("GF", pane_t=22);
WC | 8 | exterior |  | weep_cap | weep_cap("WC");
NS | 8 | exterior | 217.88 | sill_nose | sill_nose(217.88, "NS");
CMB | 4 | interior |  | cam_base | cam_base("CMB");
CMH | 4 | interior |  | cam_handle | cam_handle("CMH");
KP | 4 | interior |  | cam_keeper | cam_keeper("KP");
HG | 4 | interior |  | screen_hinge | screen_hinge("HG");
HS | 4 | interior |  | screen_leaf | screen_leaf("HS");
TC | 1 | exterior |  | test_coupon | test_coupon("TC");
BFH | 16 | interior | 208.75 | bead | bead("acrylic", 208.75, "BFH", 22);
BFV | 16 | interior | 213.0 | bead | bead("acrylic", 213.0, "BFV", 22);
BSH | 16 | interior | 185.75 | bead | bead("acrylic", 185.75, "BSH", 22);
BSV | 8 | interior | 181.0 | bead | bead("acrylic", 181.0, "BSV", 22);
AFH | 16 | exterior | 201.25 | acrylic_spacer | acrylic_spacer(201.25, "AFH", 16);
AFV | 16 | exterior | 213.5 | acrylic_spacer | acrylic_spacer(213.5, "AFV", 16);
ASH | 12 | exterior | 237.67 | acrylic_spacer | acrylic_spacer(237.67, "ASH", 16);
ASV | 8 | exterior | 182.0 | acrylic_spacer | acrylic_spacer(182.0, "ASV", 16);
AC | 16 | exterior |  | acrylic_spacer_corner | acrylic_spacer_corner("AC", 16);
