aleesposito85/openwindow/cad/stl/bench-600/TSR.stl

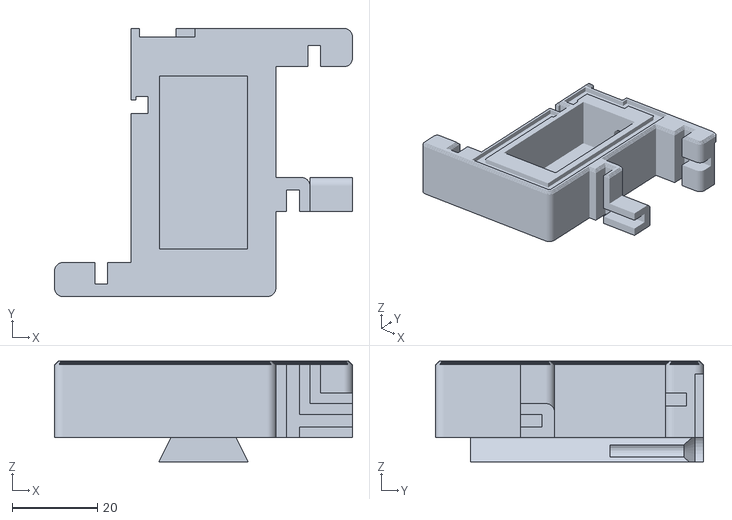
[picture p46: CAD file, 2026-10-17]
cad/stl/bench-600/TSR.stl
70.0 x 63.0 x 23.7
