aleesposito85/openwindow/cad/stl/home-1800x1500-2bay/MU.stl

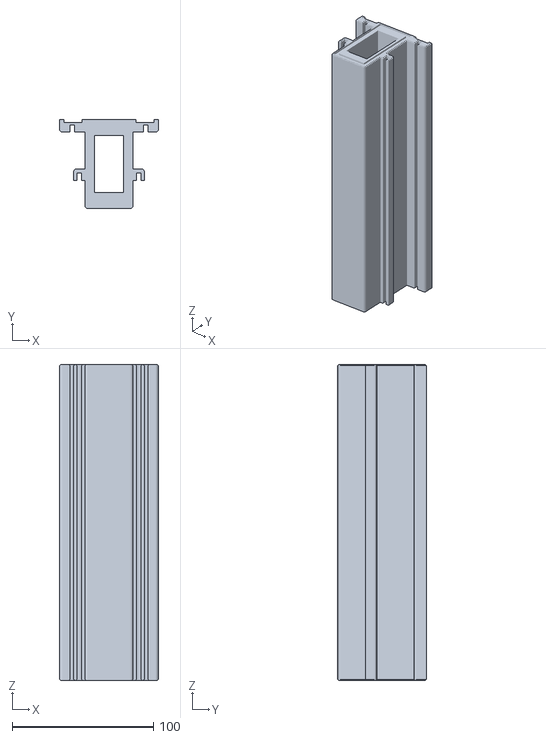
[picture p47: CAD file, 2026-10-17]
cad/stl/home-1800x1500-2bay/MU.stl
70.0 x 63.0 x 223.5
