aleesposito85/openwindow/cad/stl/home-1800x1500/CMH.stl

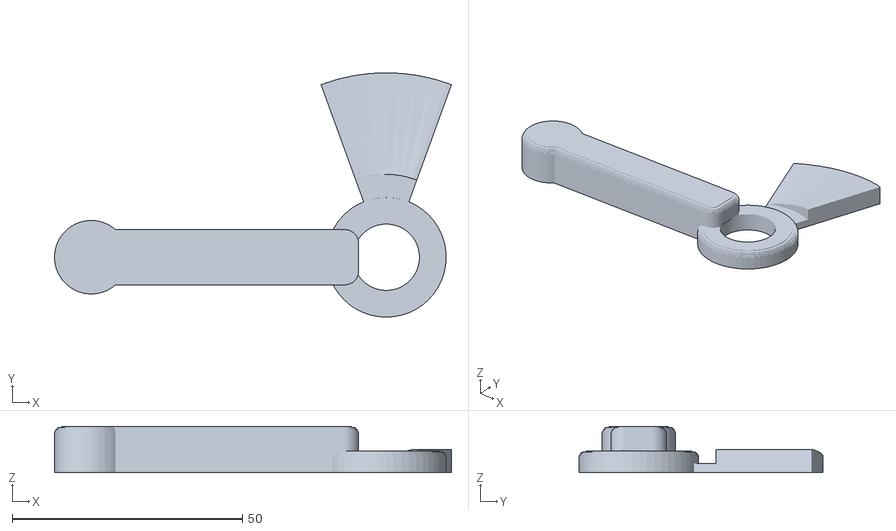
[picture p48: CAD file, 2026-10-17]
cad/stl/home-1800x1500/CMH.stl
86.1 x 53.0 x 10.0
