aleesposito85/openwindow/cad/stl/my-window/SN.stl

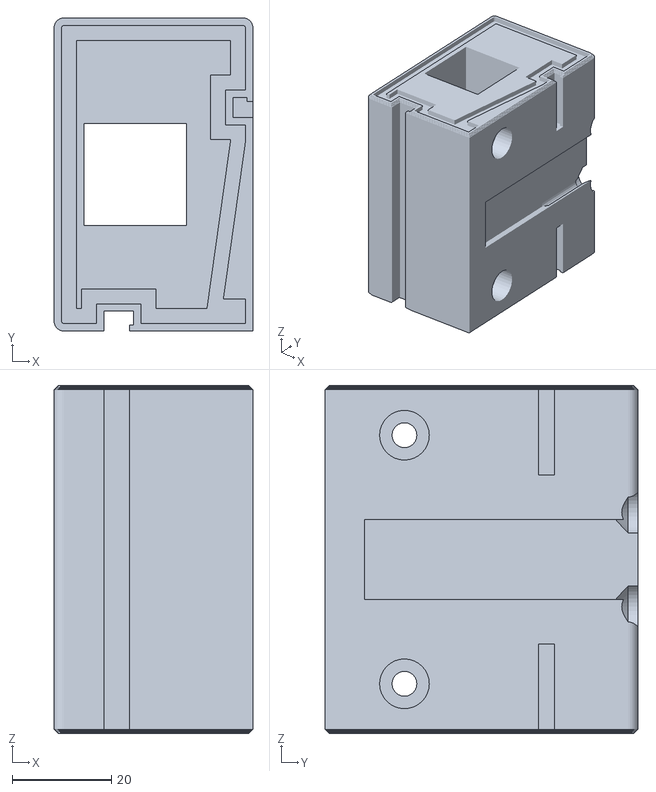
[picture p49: CAD file, 2026-10-17]
cad/stl/my-window/SN.stl
40.0 x 63.0 x 70.0
