aleesposito85/openwindow/cad/stl/bench-600/JL.stl

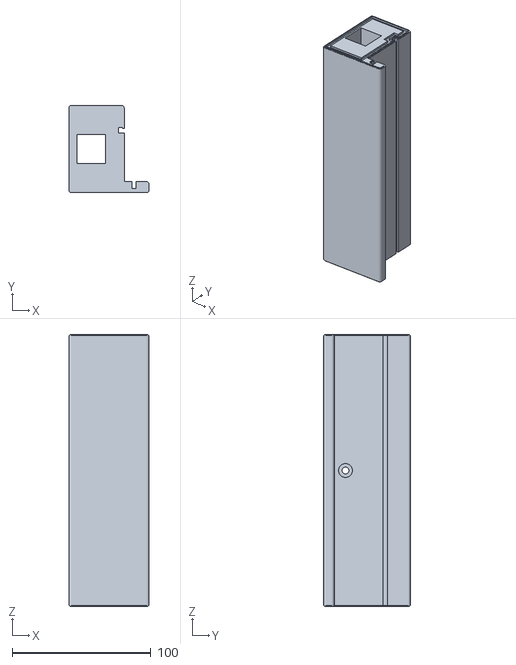
[picture p50: CAD file, 2026-10-17]
cad/stl/bench-600/JL.stl
58.0 x 63.0 x 196.0
