aleesposito85/openwindow/cad/stl/home-1800x1500-2bay/MSL.stl

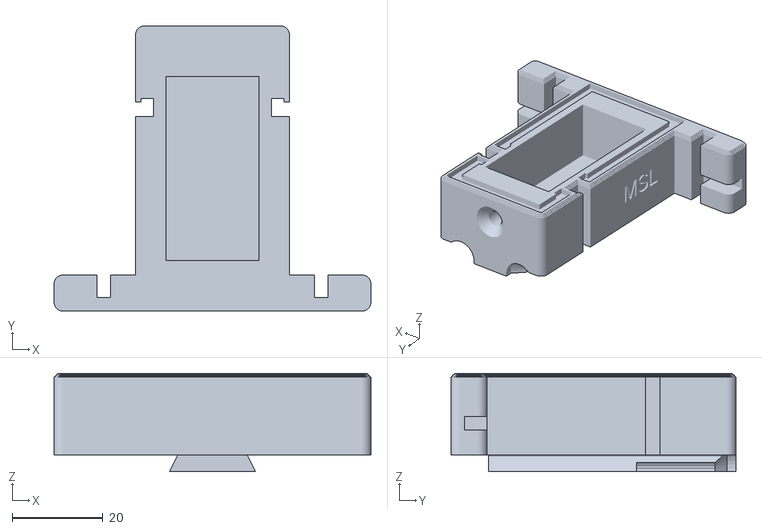
[picture p51: CAD file, 2026-10-17]
cad/stl/home-1800x1500-2bay/MSL.stl
70.0 x 63.0 x 21.7
