aleesposito85/openwindow/cad/stl/home-1800x1500/SB.stl

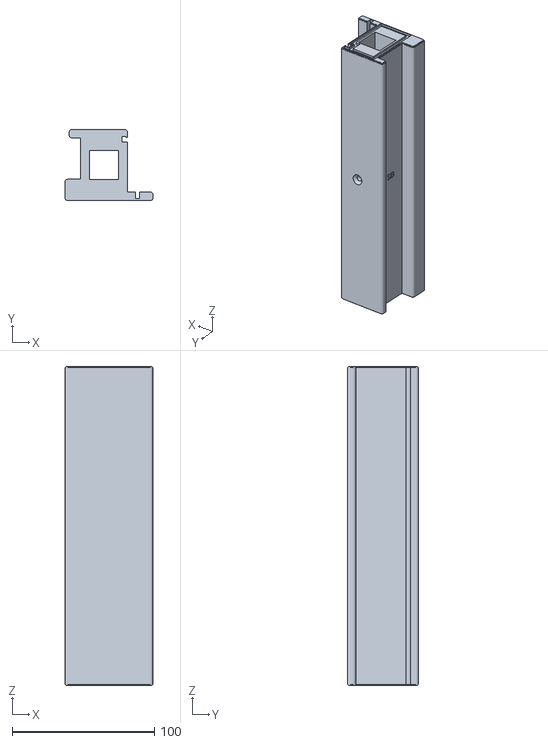
[picture p52: CAD file, 2026-10-17]
cad/stl/home-1800x1500/SB.stl
62.0 x 50.0 x 224.0
