aleesposito85/openwindow/cad/stl/my-window/ASH.stl

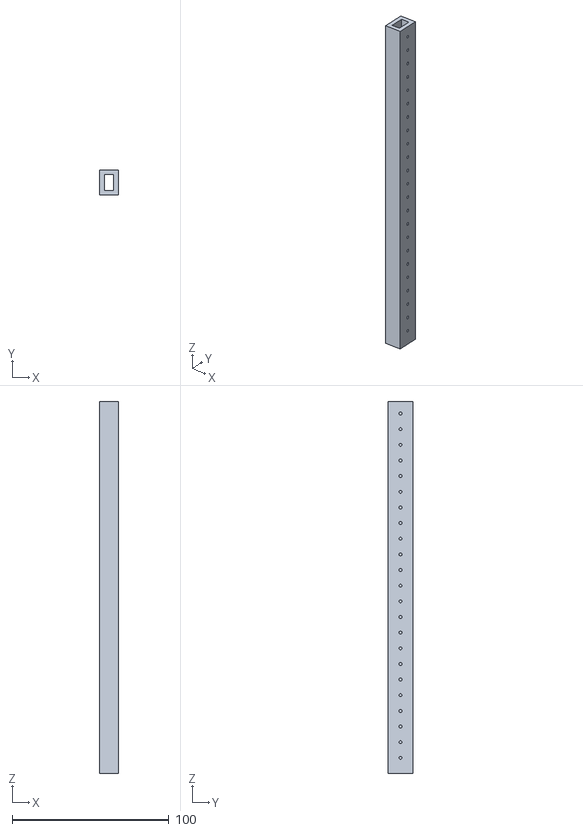
[picture p53: CAD file, 2026-10-17]
cad/stl/my-window/ASH.stl
12.0 x 16.0 x 237.7
