aleesposito85/openwindow/cad/stl/bench-600/ASV.stl

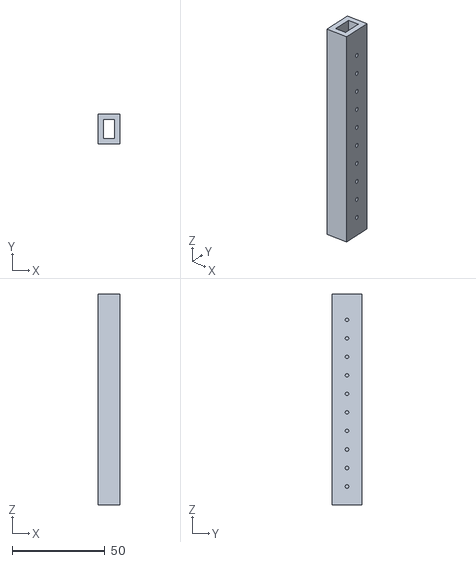
[picture p54: CAD file, 2026-10-17]
cad/stl/bench-600/ASV.stl
12.0 x 16.0 x 114.0
