aleesposito85/openwindow/cad/stl/home-1800x1500-2bay/JL.stl

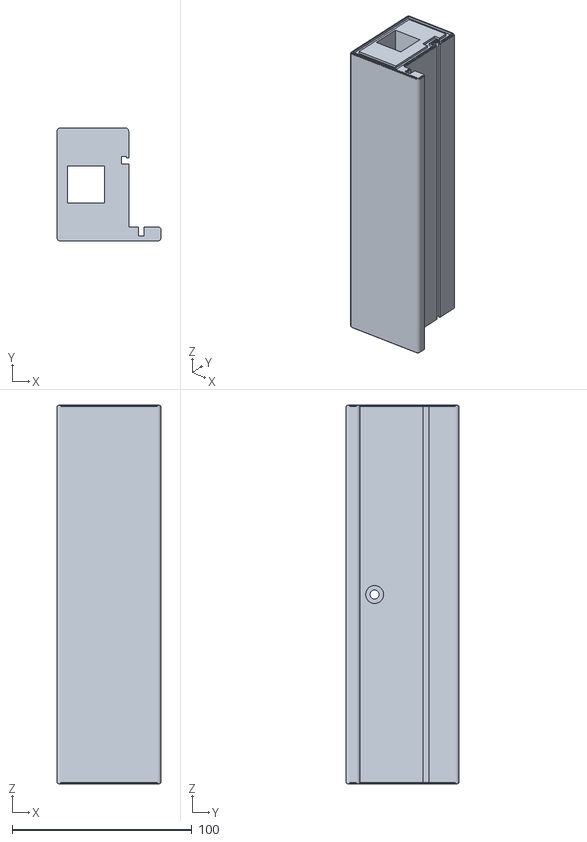
[picture p55: CAD file, 2026-10-17]
cad/stl/home-1800x1500-2bay/JL.stl
58.0 x 63.0 x 210.8
