aleesposito85/openwindow/cad/stl/home-1800x1500/TE.stl

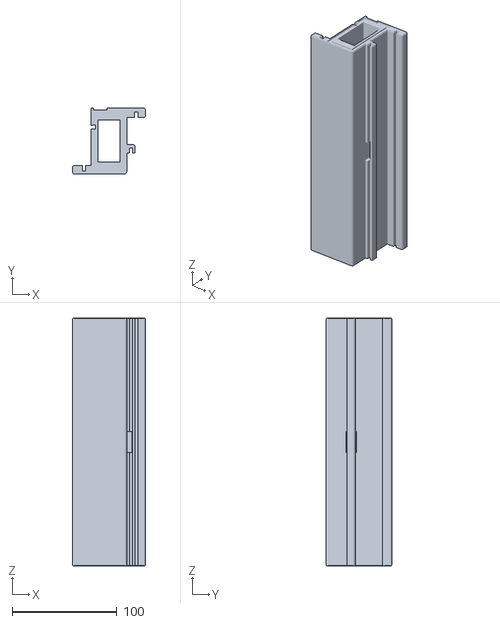
[picture p56: CAD file, 2026-10-17]
cad/stl/home-1800x1500/TE.stl
70.0 x 63.0 x 237.1
