aleesposito85/openwindow/cad/stl/my-window/TE.stl

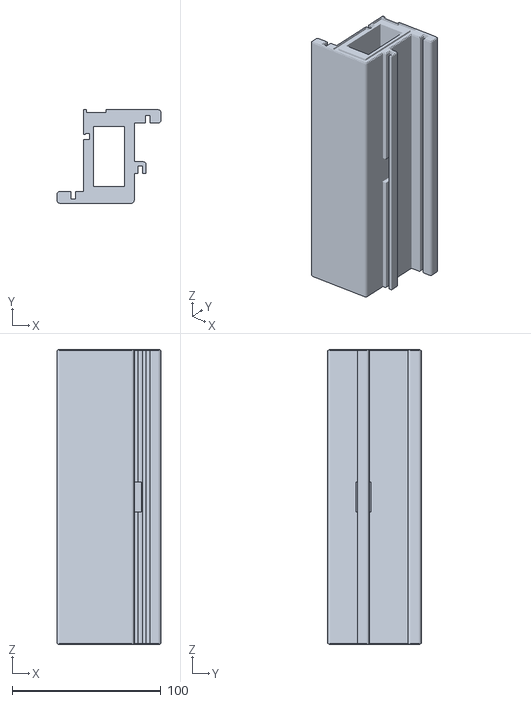
[picture p57: CAD file, 2026-10-17]
cad/stl/my-window/TE.stl
70.0 x 63.0 x 198.5
