aleesposito85/openwindow/cad/stl/bench-600/HS.stl

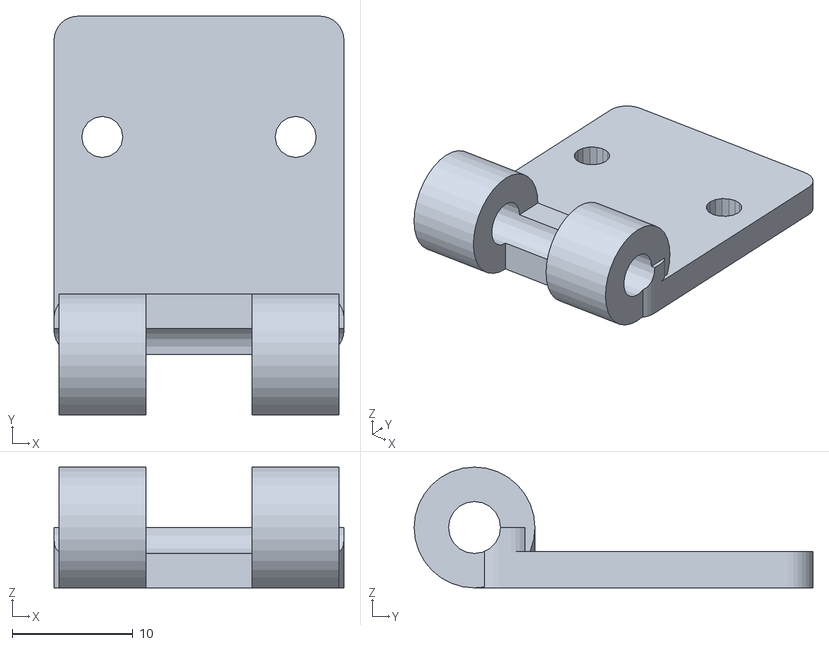
[picture p58: CAD file, 2026-10-17]
cad/stl/bench-600/HS.stl
24.0 x 33.0 x 10.0
