aleesposito85/openwindow/cad/stl/home-1800x1500-2bay/NS.stl

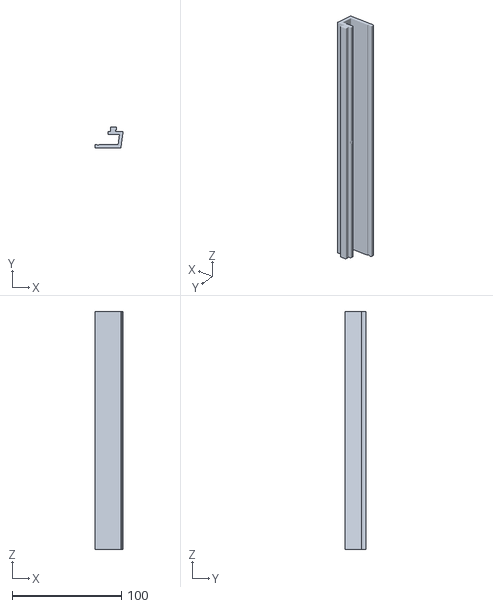
[picture p59: CAD file, 2026-10-17]
cad/stl/home-1800x1500-2bay/NS.stl
26.0 x 18.8 x 217.9
