aleesposito85/openwindow/cad/stl/home-1800x1500/SV.stl

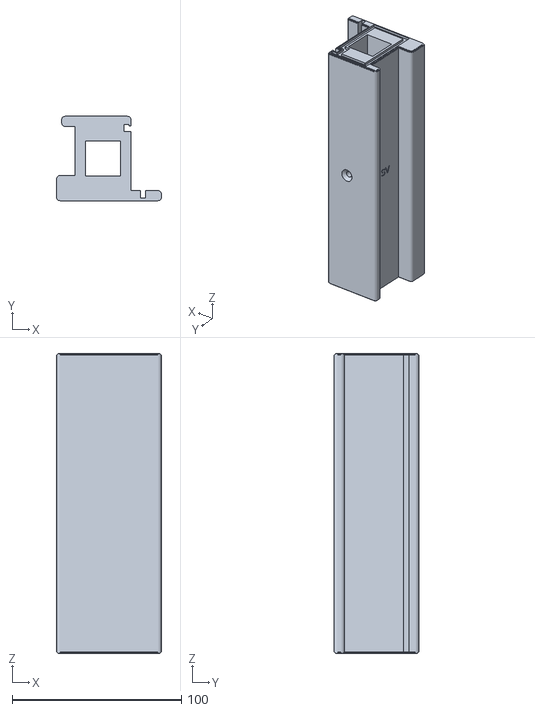
[picture p60: CAD file, 2026-10-17]
cad/stl/home-1800x1500/SV.stl
62.0 x 50.0 x 177.5
