aleesposito85/openwindow/cad/stl/my-window/CS.stl

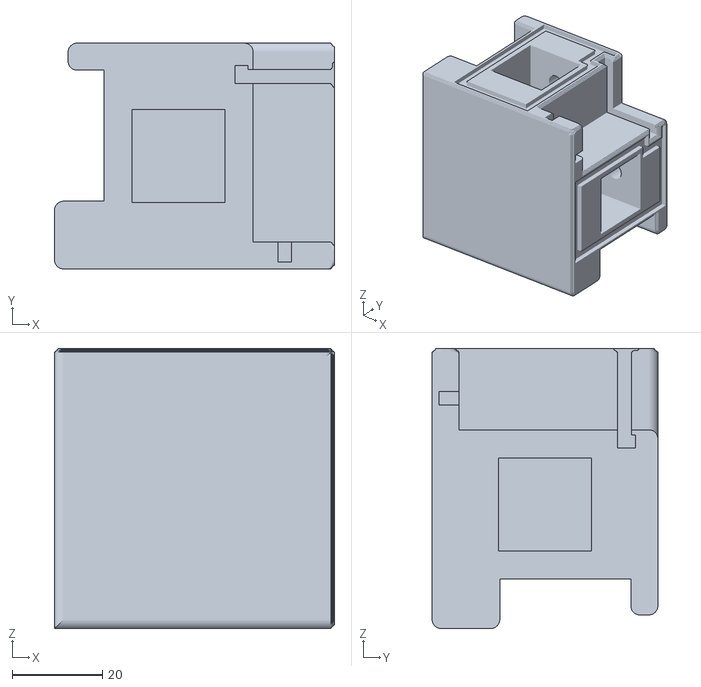
[picture p61: CAD file, 2026-10-17]
cad/stl/my-window/CS.stl
62.0 x 50.0 x 62.0
