aleesposito85/openwindow/cad/stl/bench-600/H.stl

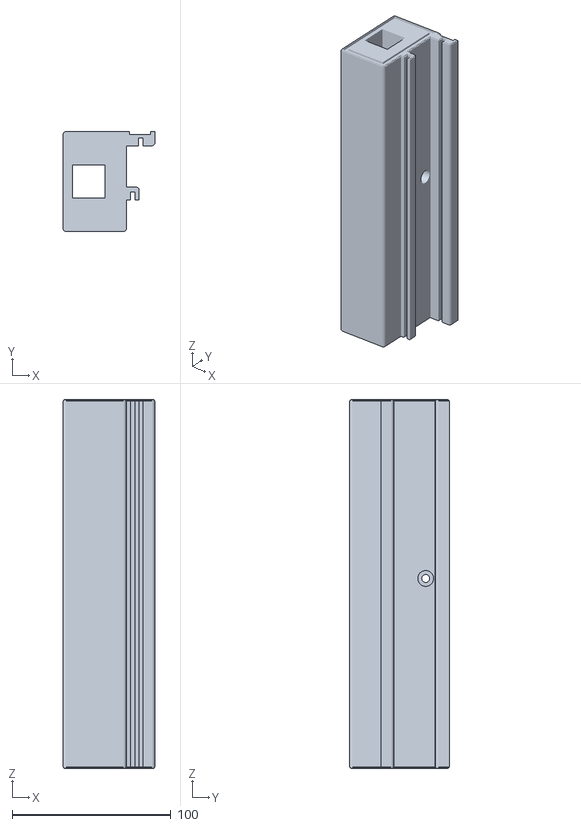
[picture p62: CAD file, 2026-10-17]
cad/stl/bench-600/H.stl
58.0 x 63.0 x 232.5
