aleesposito85/openwindow/cad/stl/home-1800x1500-2bay/NH.stl

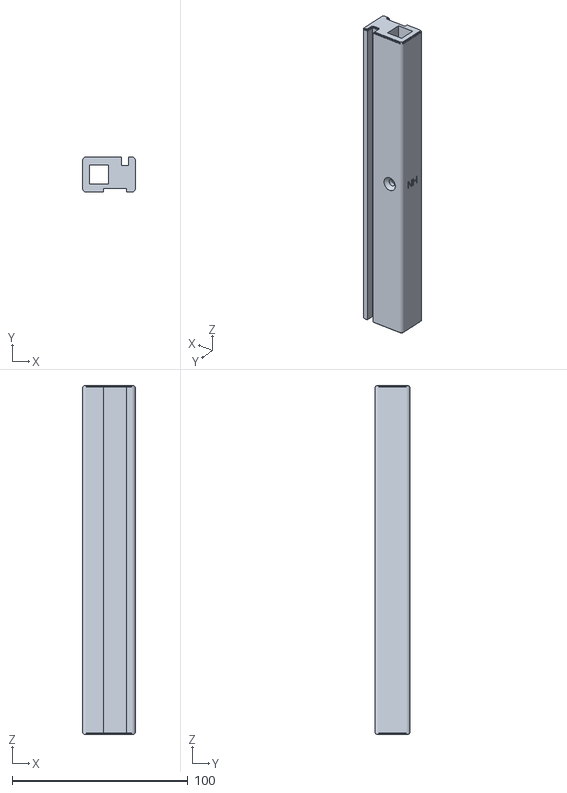
[picture p63: CAD file, 2026-10-17]
cad/stl/home-1800x1500-2bay/NH.stl
30.0 x 20.0 x 198.8
