aleesposito85/openwindow/cad/stl/home-1800x1500/CSR.stl

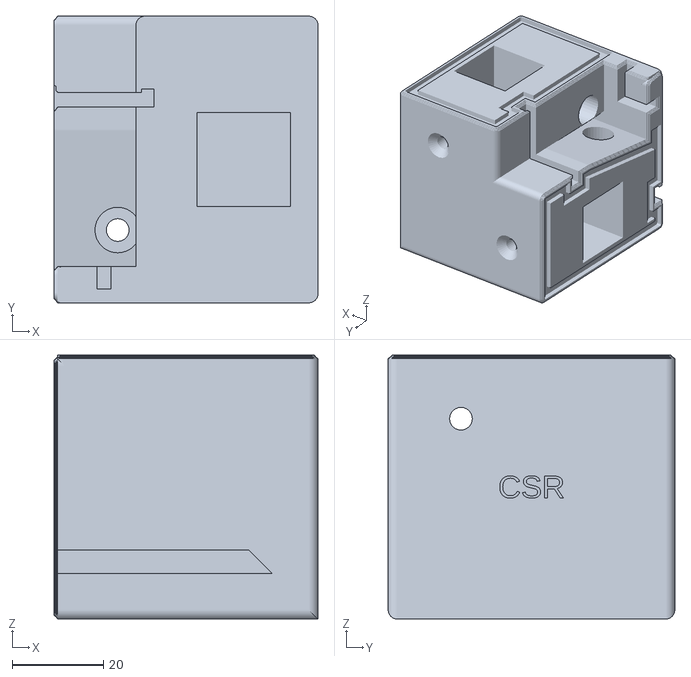
[picture p64: CAD file, 2026-10-17]
cad/stl/home-1800x1500/CSR.stl
58.0 x 63.0 x 58.0
