aleesposito85/openwindow/cad/stl/my-window/HG.stl

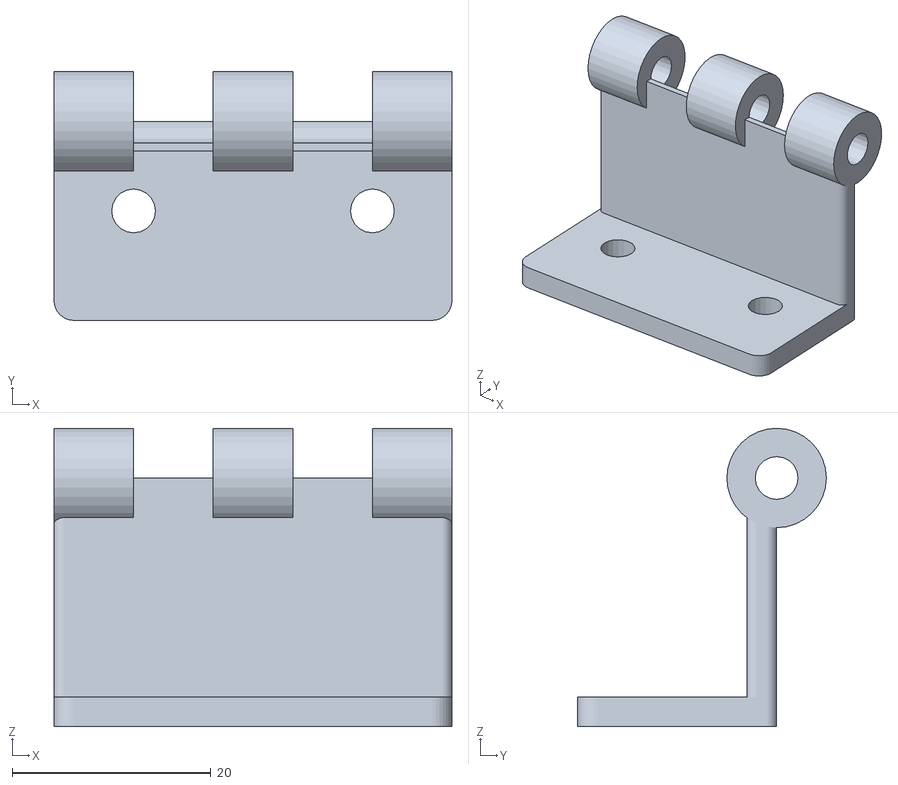
[picture p65: CAD file, 2026-10-17]
cad/stl/my-window/HG.stl
40.0 x 25.0 x 30.0
