aleesposito85/openwindow/cad/stl/bench-600/CN.stl

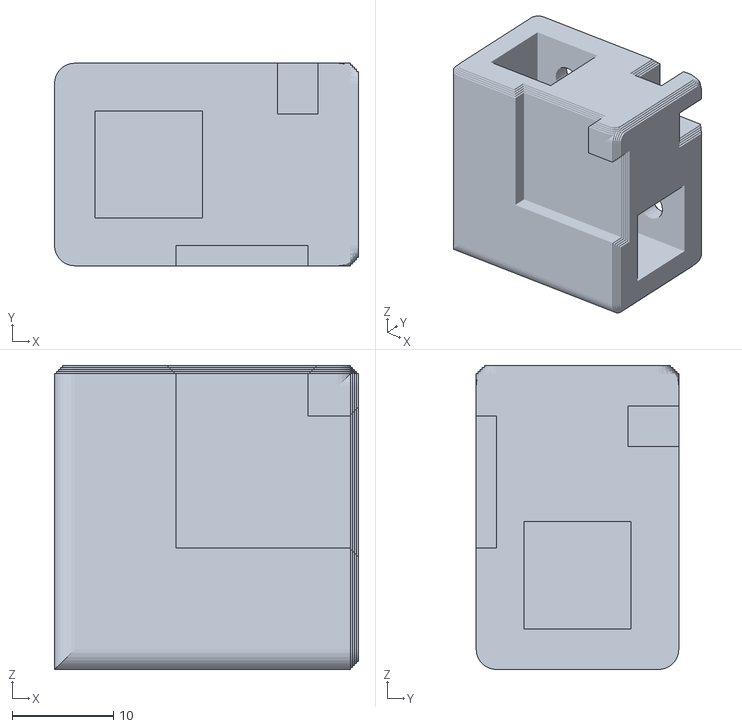
[picture p66: CAD file, 2026-10-17]
cad/stl/bench-600/CN.stl
30.0 x 20.0 x 30.0
