aleesposito85/openwindow/cad/stl/home-1800x1500-2bay/HN.stl

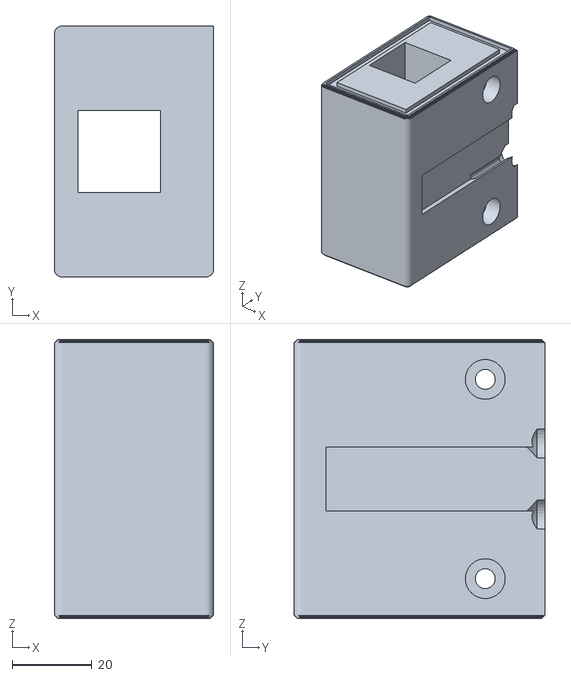
[picture p67: CAD file, 2026-10-17]
cad/stl/home-1800x1500-2bay/HN.stl
40.0 x 63.0 x 70.0
