aleesposito85/openwindow/cad/stl/my-window/TC.stl

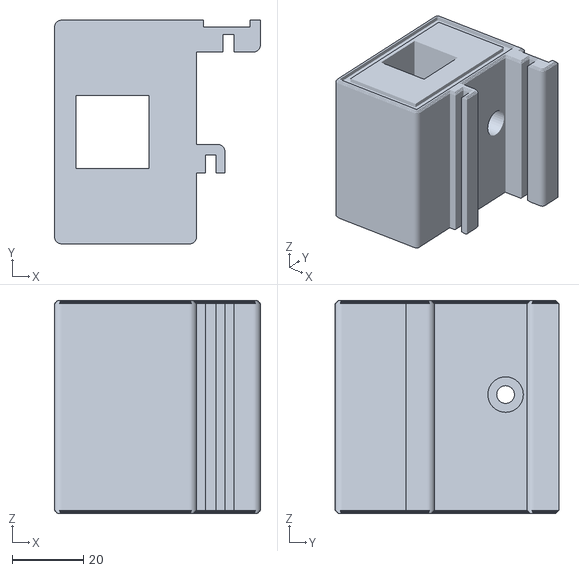
[picture p68: CAD file, 2026-10-17]
cad/stl/my-window/TC.stl
58.0 x 63.0 x 60.0
