aleesposito85/openwindow/cad/stl/bench-600/JU.stl

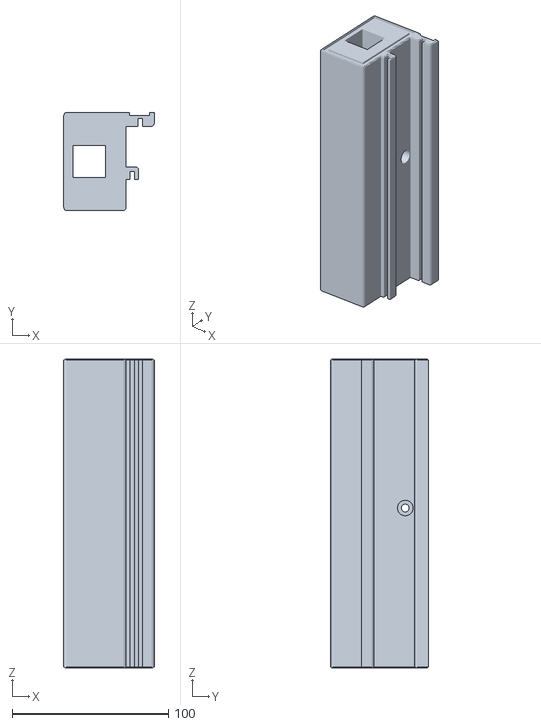
[picture p69: CAD file, 2026-10-17]
cad/stl/bench-600/JU.stl
58.0 x 63.0 x 198.0
