aleesposito85/openwindow/cad/stl/home-1800x1500-2bay/MST.stl

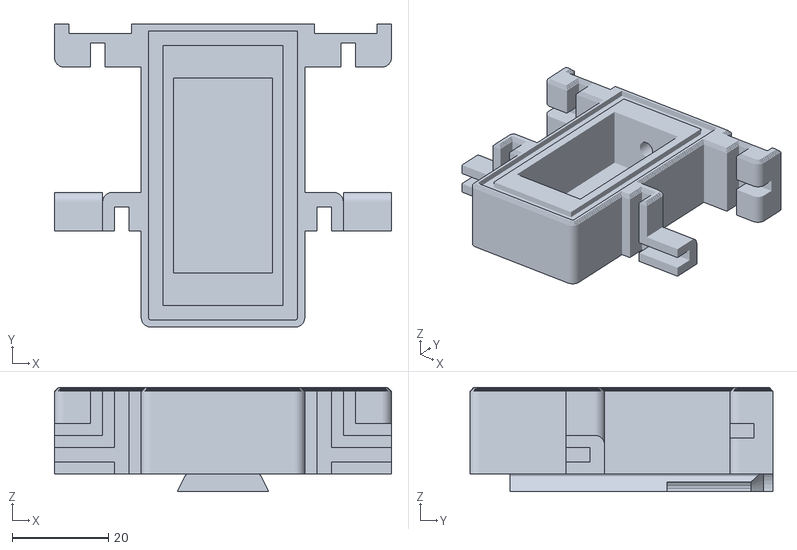
[picture p70: CAD file, 2026-10-17]
cad/stl/home-1800x1500-2bay/MST.stl
70.0 x 63.0 x 21.7
