aleesposito85/openwindow/cad/stl/home-1800x1500/CH.stl

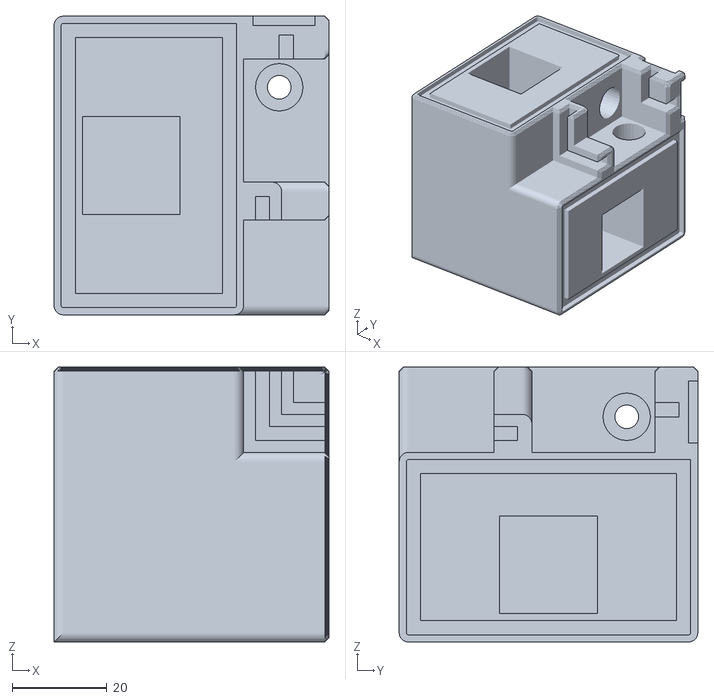
[picture p71: CAD file, 2026-10-17]
cad/stl/home-1800x1500/CH.stl
58.0 x 63.0 x 58.0
