aleesposito85/openwindow/cad/stl/my-window/NV.stl

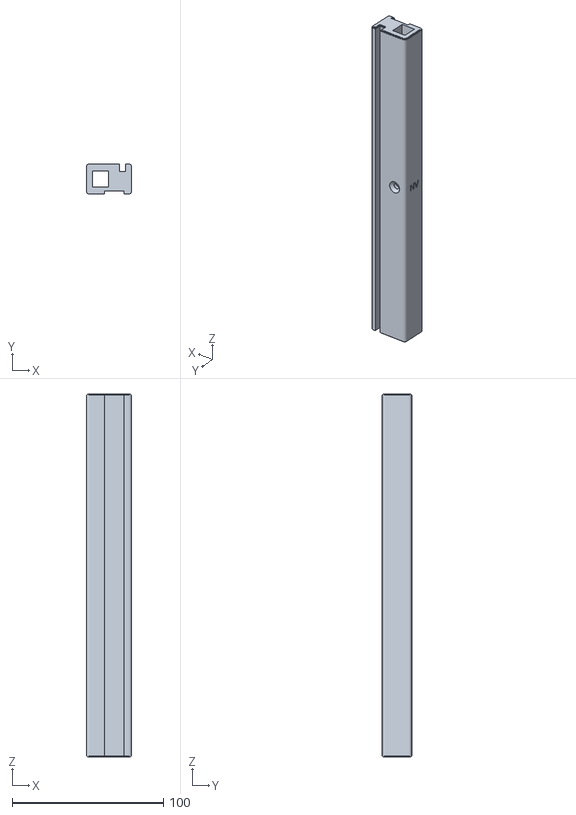
[picture p72: CAD file, 2026-10-17]
cad/stl/my-window/NV.stl
30.0 x 20.0 x 240.0
