aleesposito85/openwindow/cad/stl/home-1800x1500-2bay/KP.stl

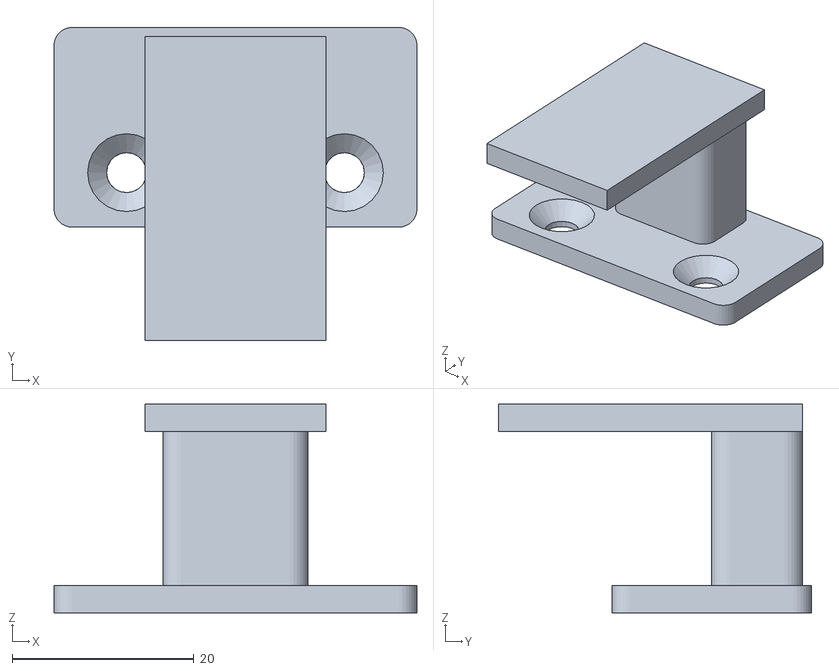
[picture p73: CAD file, 2026-10-17]
cad/stl/home-1800x1500-2bay/KP.stl
40.0 x 34.5 x 23.0
