aleesposito85/openwindow/cad/stl/bench-600/BFH.stl

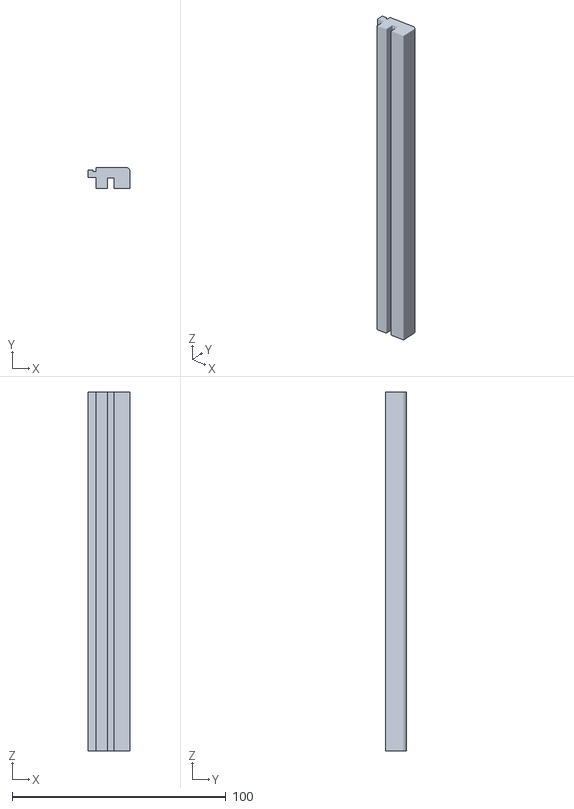
[picture p74: CAD file, 2026-10-17]
cad/stl/bench-600/BFH.stl
19.8 x 10.0 x 168.0
