aleesposito85/openwindow/cad/stl/bench-600/ASH.stl

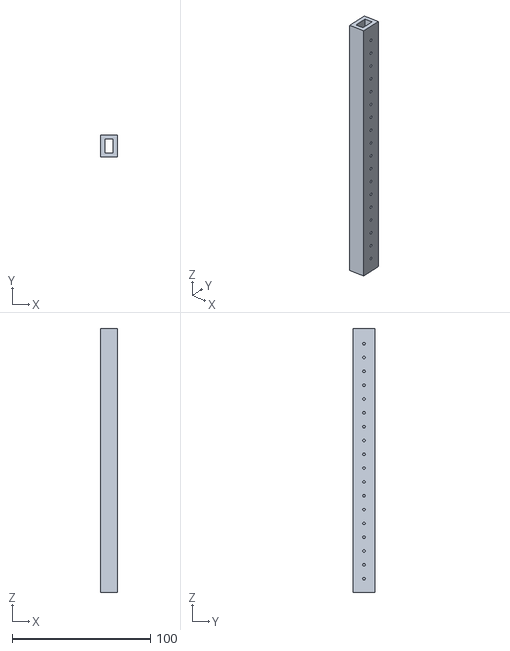
[picture p75: CAD file, 2026-10-17]
cad/stl/bench-600/ASH.stl
12.0 x 16.0 x 191.0
