aleesposito85/openwindow/cad/stl/home-1800x1500/H.stl

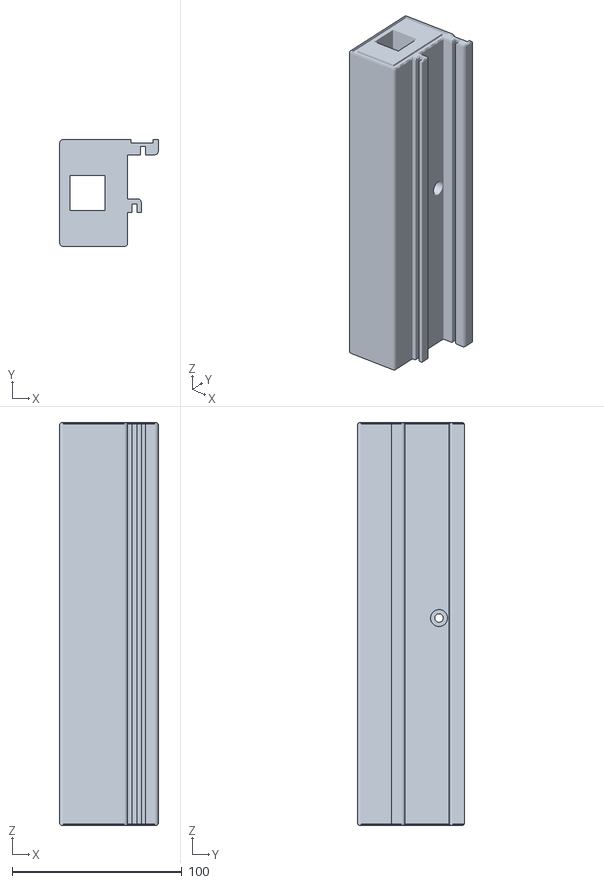
[picture p76: CAD file, 2026-10-17]
cad/stl/home-1800x1500/H.stl
58.0 x 63.0 x 237.1
