aleesposito85/openwindow/cad/stl/bench-600/NH.stl

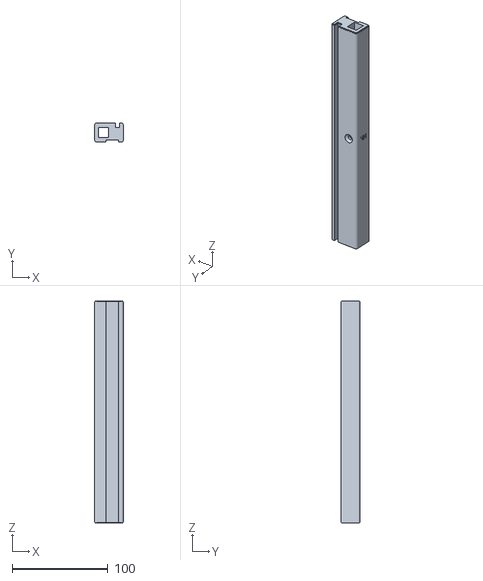
[picture p77: CAD file, 2026-10-17]
cad/stl/bench-600/NH.stl
30.0 x 20.0 x 232.0
