aleesposito85/openwindow/cad/stl/home-1800x1500-2bay/GW.stl

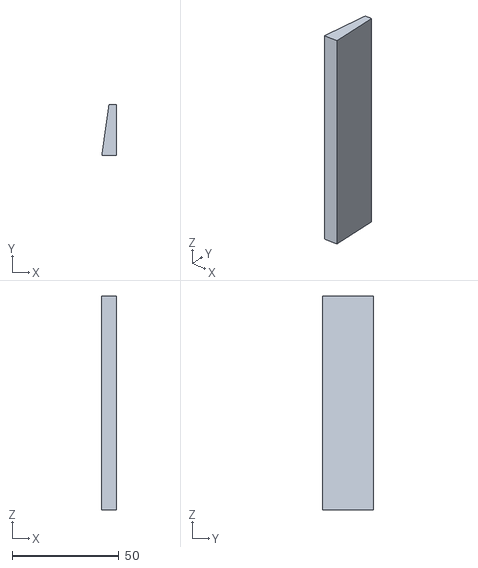
[picture p78: CAD file, 2026-10-17]
cad/stl/home-1800x1500-2bay/GW.stl
6.79 x 24.0 x 100.0
