aleesposito85/openwindow/cad/stl/my-window/ASV.stl

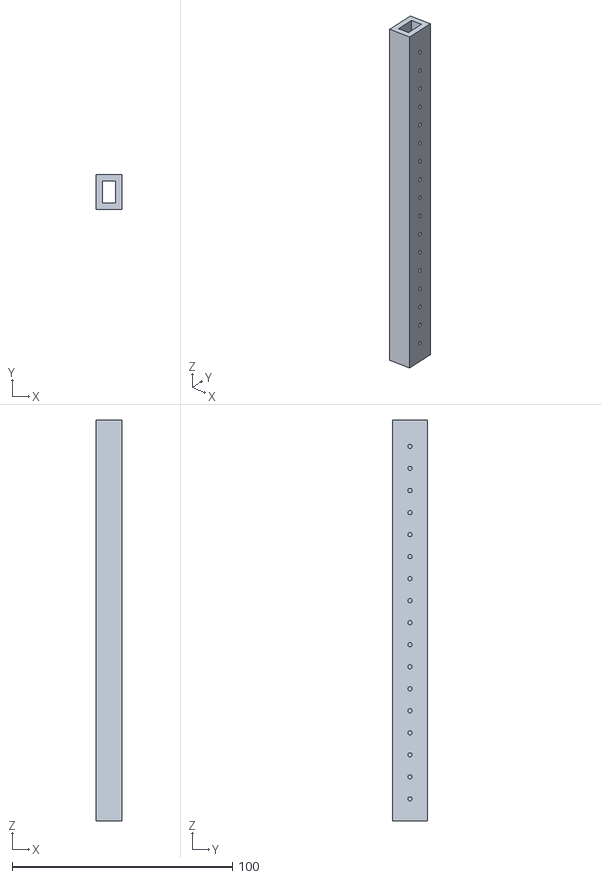
[picture p79: CAD file, 2026-10-17]
cad/stl/my-window/ASV.stl
12.0 x 16.0 x 182.0
