aleesposito85/openwindow/cad/stl/my-window/AC.stl

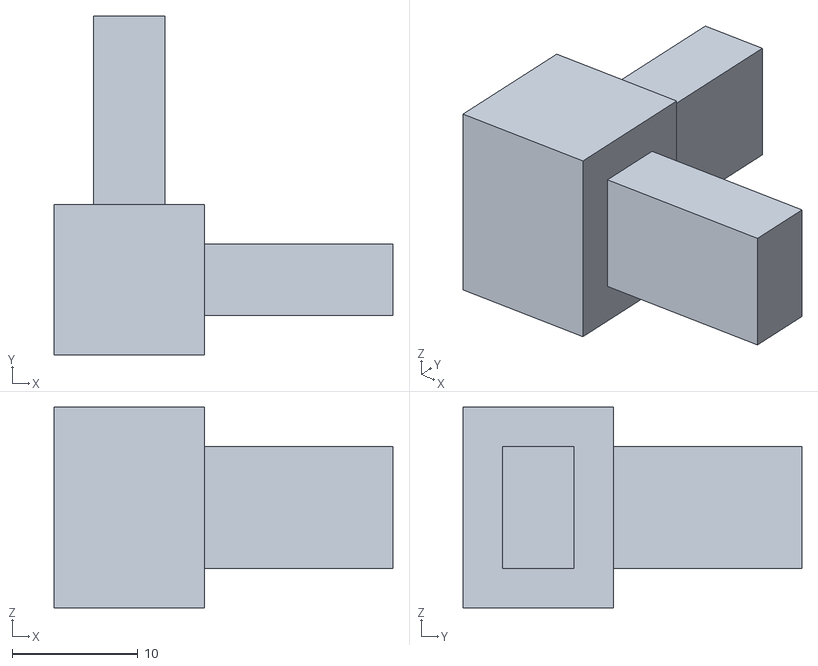
[picture p80: CAD file, 2026-10-17]
cad/stl/my-window/AC.stl
27.0 x 27.0 x 16.0
