aleesposito85/openwindow/cad/stl/bench-600/NV.stl

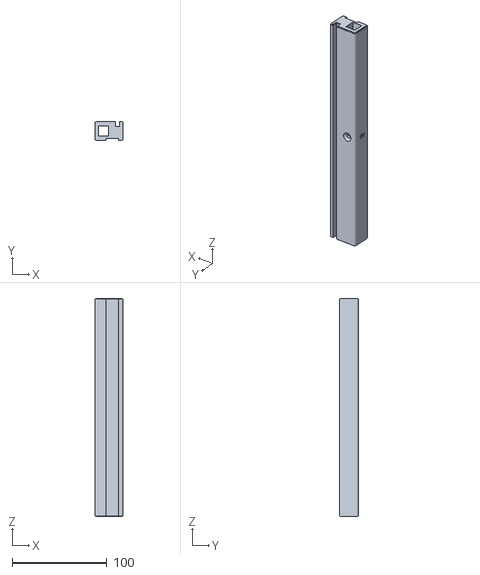
[picture p81: CAD file, 2026-10-17]
cad/stl/bench-600/NV.stl
30.0 x 20.0 x 230.0
