aleesposito85/openwindow/cad/stl/home-1800x1500/BSH.stl

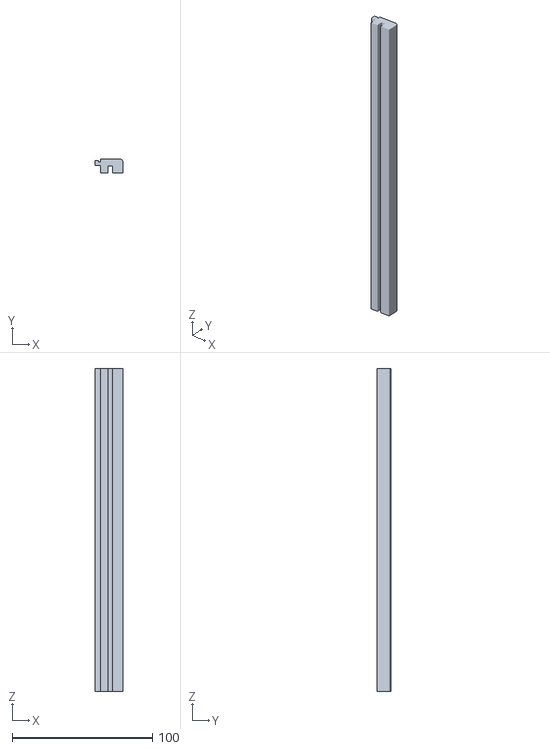
[picture p82: CAD file, 2026-10-17]
cad/stl/home-1800x1500/BSH.stl
19.8 x 10.0 x 230.3
