aleesposito85/openwindow/cad/stl/home-1800x1500/JU.stl

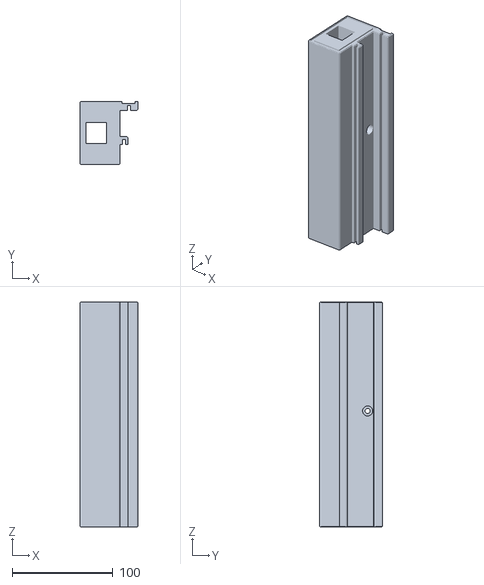
[picture p83: CAD file, 2026-10-17]
cad/stl/home-1800x1500/JU.stl
58.0 x 63.0 x 223.5
