aleesposito85/openwindow/cad/stl/home-1800x1500/S.stl

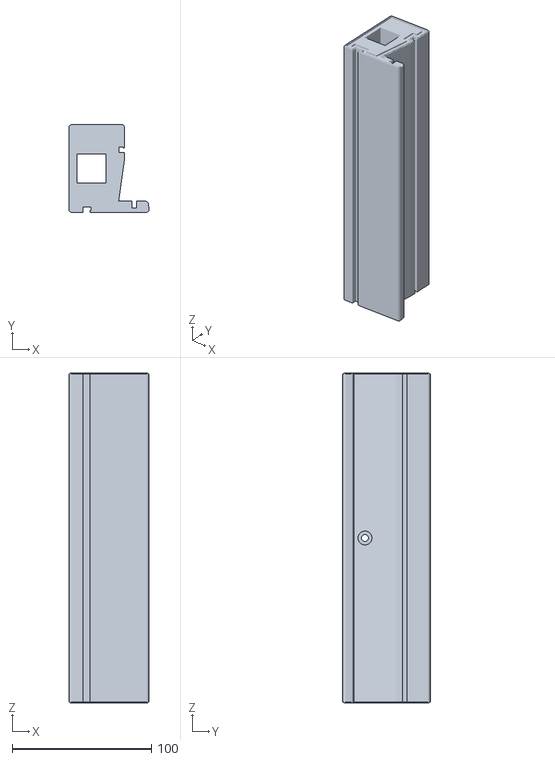
[picture p84: CAD file, 2026-10-17]
cad/stl/home-1800x1500/S.stl
57.7 x 63.0 x 237.1
