aleesposito85/openwindow/cad/stl/my-window/ML.stl

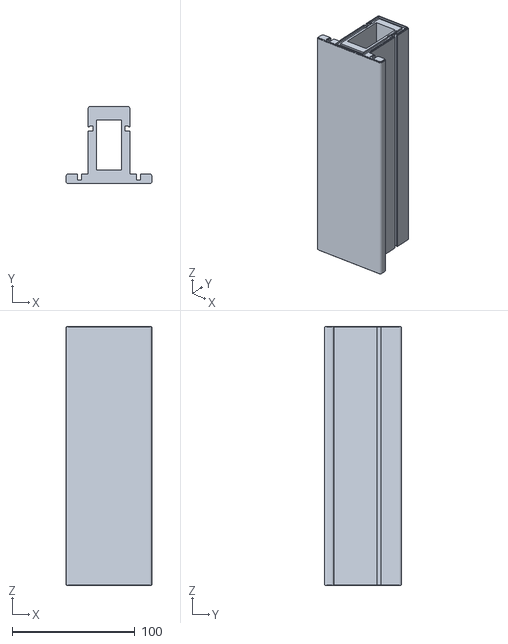
[picture p85: CAD file, 2026-10-17]
cad/stl/my-window/ML.stl
70.0 x 63.0 x 210.8
