aleesposito85/openwindow/cad/stl/bench-600/WC.stl

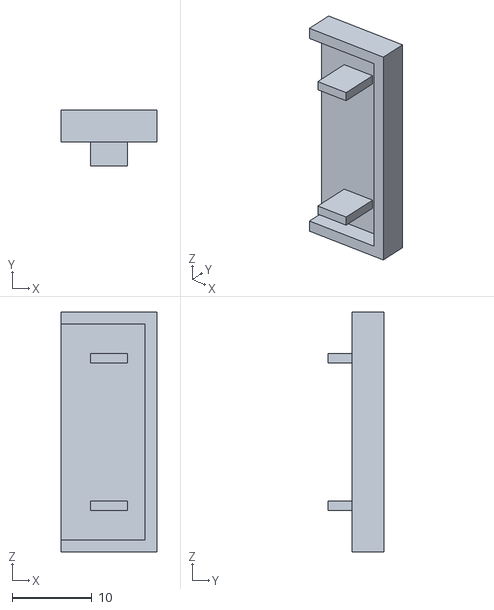
[picture p86: CAD file, 2026-10-17]
cad/stl/bench-600/WC.stl
12.0 x 7.00 x 30.0
