aleesposito85/openwindow/cad/stl/my-window/GW.stl

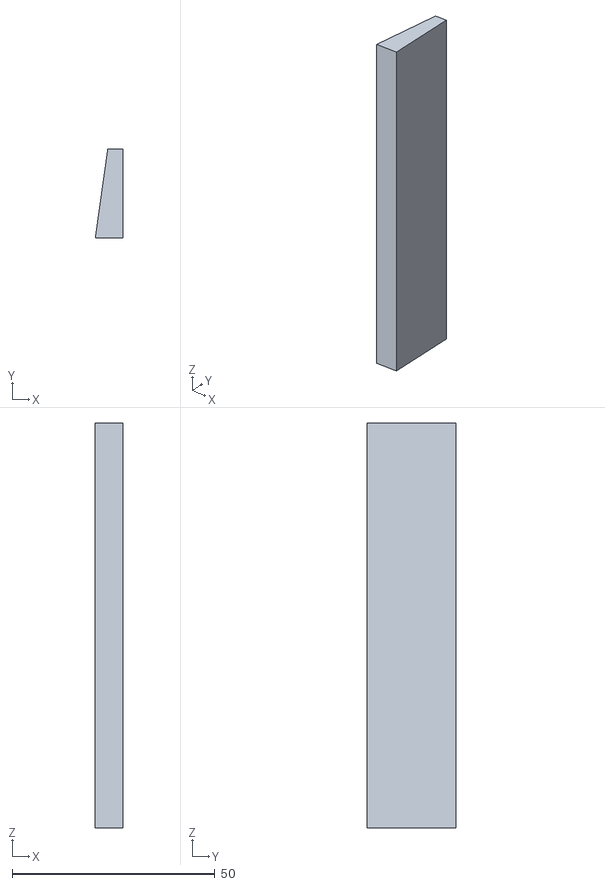
[picture p87: CAD file, 2026-10-17]
cad/stl/my-window/GW.stl
6.79 x 22.0 x 100.0
