aleesposito85/openwindow/cad/stl/bench-600/SW.stl

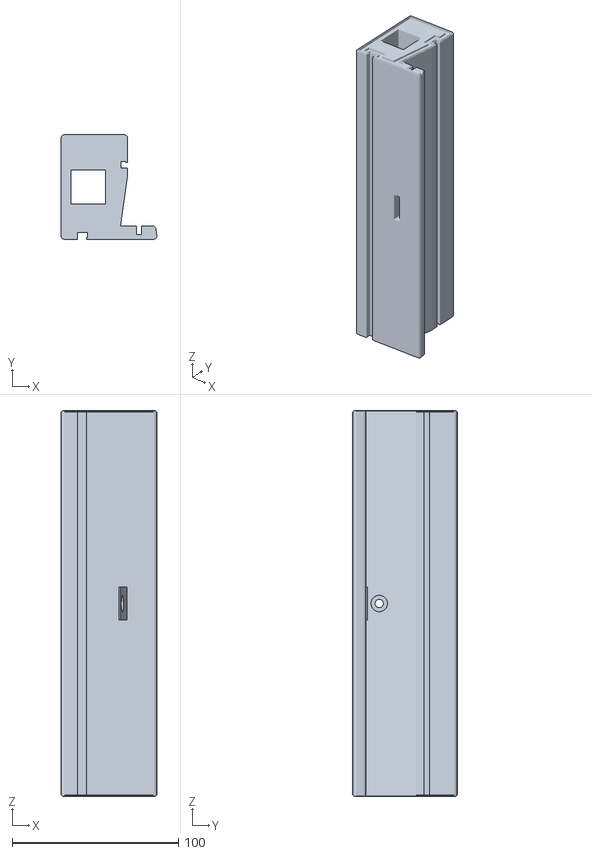
[picture p88: CAD file, 2026-10-17]
cad/stl/bench-600/SW.stl
57.7 x 63.0 x 232.5
