aleesposito85/openwindow/cad/stl/home-1800x1500/BFV.stl

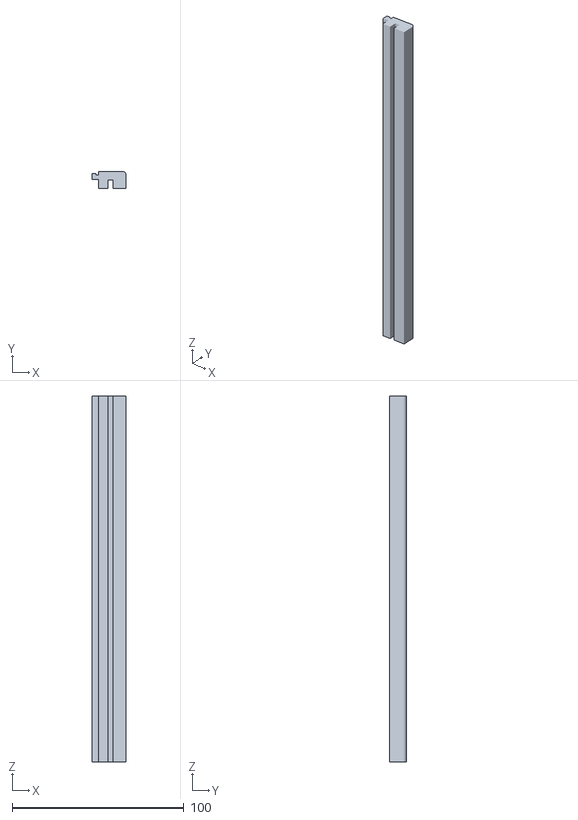
[picture p89: CAD file, 2026-10-17]
cad/stl/home-1800x1500/BFV.stl
19.8 x 10.0 x 213.0
