aleesposito85/openwindow/cad/stl/my-window/SB.stl

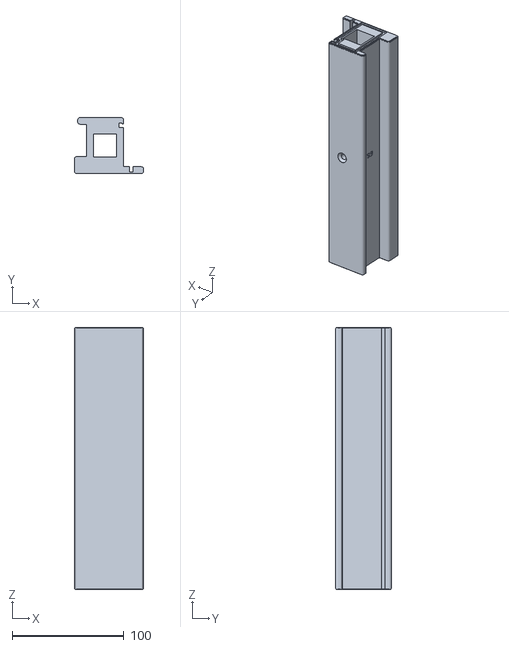
[picture p90: CAD file, 2026-10-17]
cad/stl/my-window/SB.stl
62.0 x 50.0 x 234.3
