aleesposito85/openwindow/cad/stl/my-window/AFV.stl

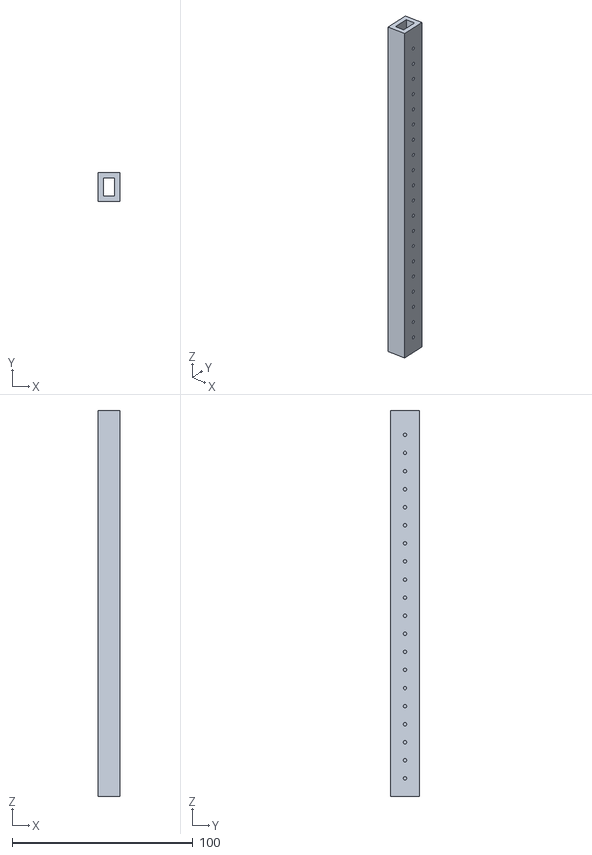
[picture p91: CAD file, 2026-10-17]
cad/stl/my-window/AFV.stl
12.0 x 16.0 x 213.5
