aleesposito85/openwindow/cad/stl/bench-600/CMB.stl

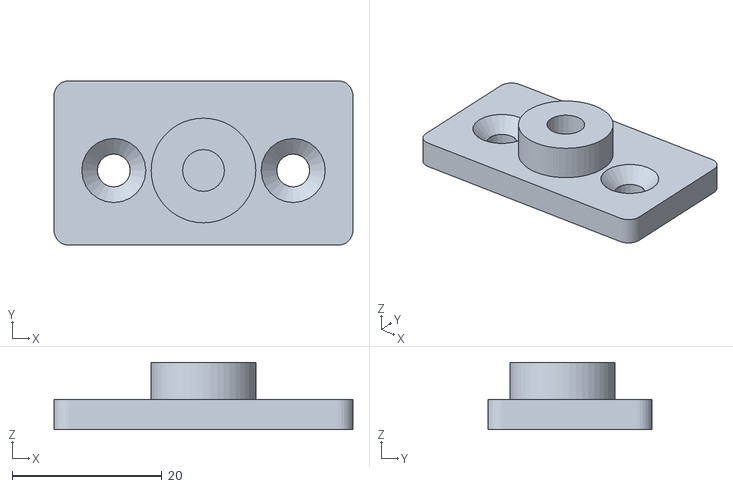
[picture p92: CAD file, 2026-10-17]
cad/stl/bench-600/CMB.stl
40.0 x 22.0 x 9.00
