aleesposito85/openwindow/cad/stl/home-1800x1500-2bay/GF.stl

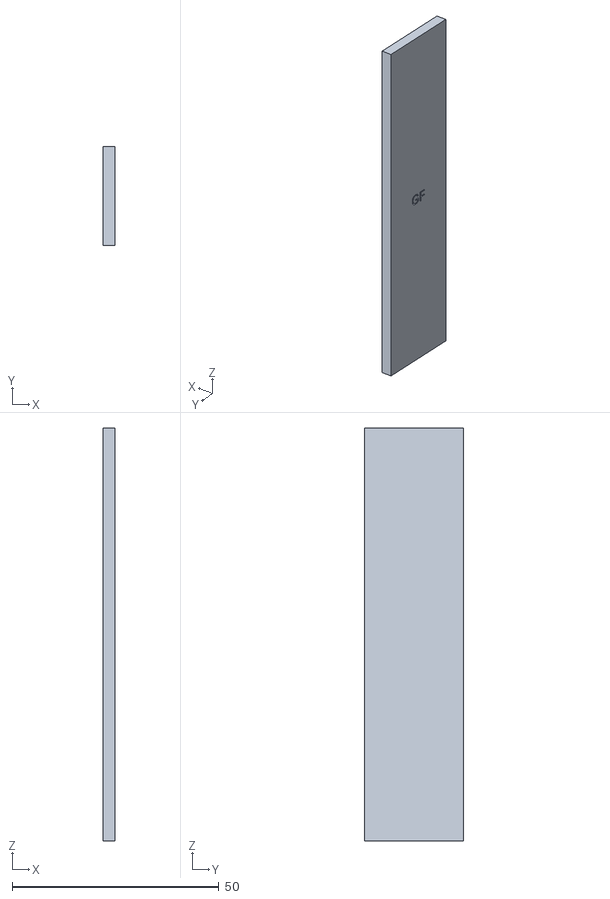
[picture p93: CAD file, 2026-10-17]
cad/stl/home-1800x1500-2bay/GF.stl
3.00 x 24.0 x 100.0
