aleesposito85/openwindow/cad/stl/bench-600/NS.stl

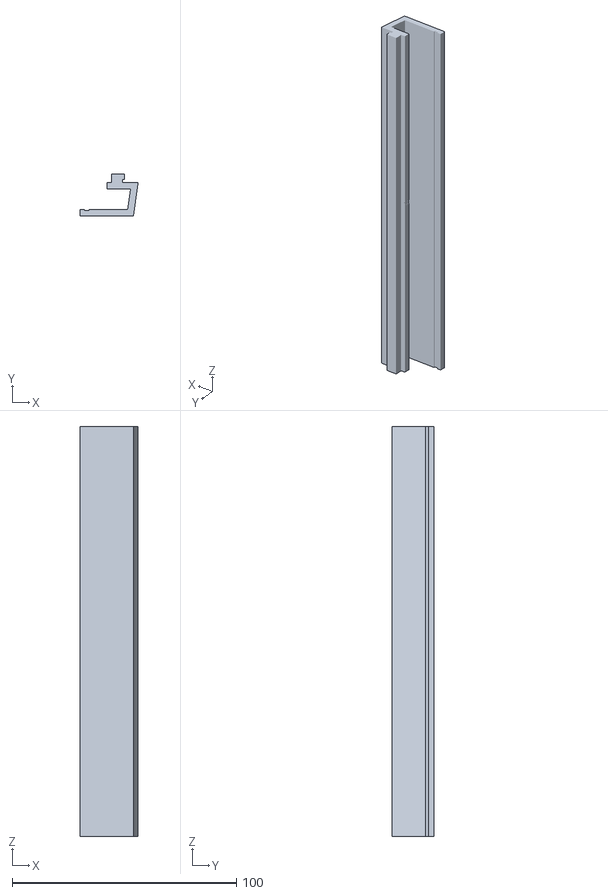
[picture p94: CAD file, 2026-10-17]
cad/stl/bench-600/NS.stl
26.0 x 18.8 x 182.7
