aleesposito85/openwindow/cad/stl/home-1800x1500-2bay/CS.stl

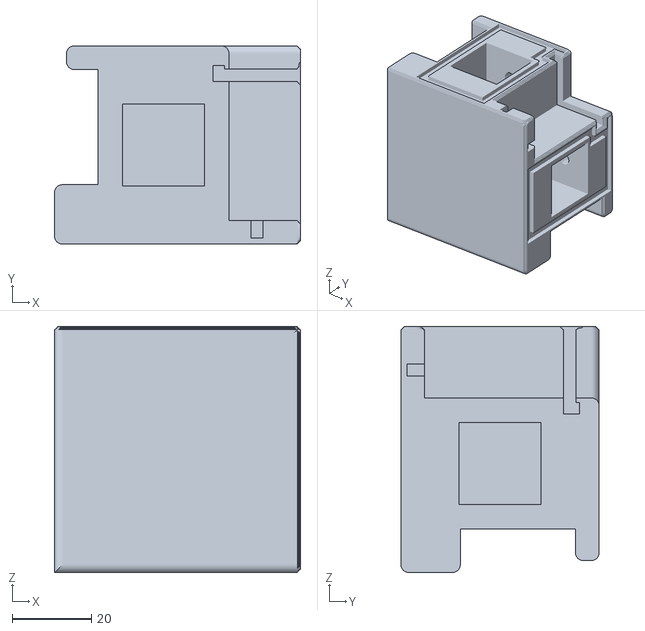
[picture p95: CAD file, 2026-10-17]
cad/stl/home-1800x1500-2bay/CS.stl
62.0 x 50.0 x 62.0
