aleesposito85/openwindow/cad/stl/bench-600/BFV.stl

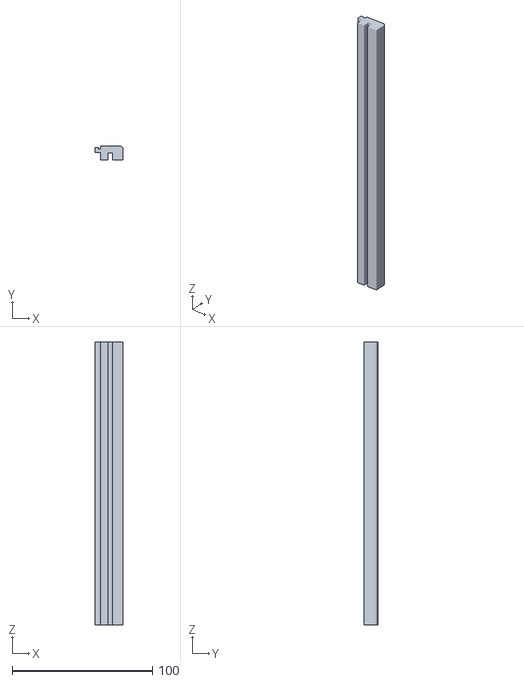
[picture p96: CAD file, 2026-10-17]
cad/stl/bench-600/BFV.stl
19.8 x 10.0 x 202.0
