aleesposito85/openwindow/cad/stl/home-1800x1500/BSV.stl

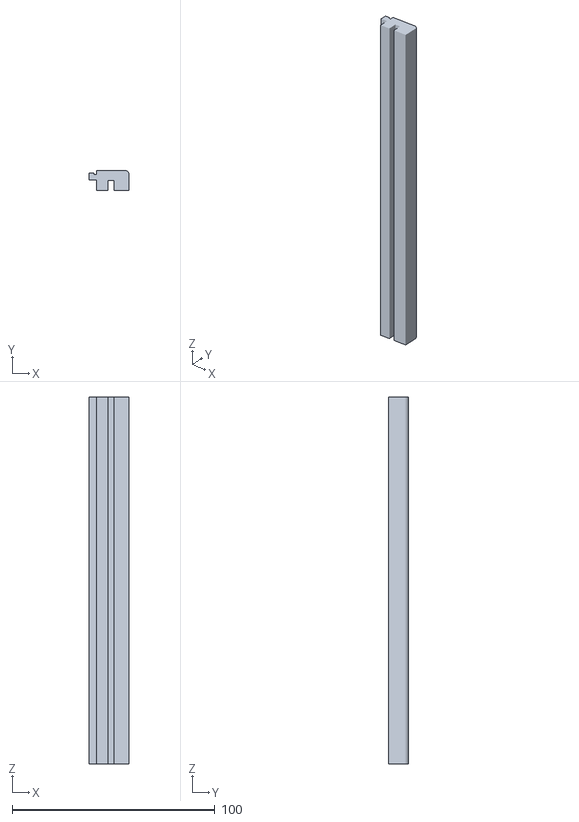
[picture p97: CAD file, 2026-10-17]
cad/stl/home-1800x1500/BSV.stl
19.8 x 10.0 x 181.0
