aleesposito85/openwindow/cad/stl/home-1800x1500-2bay/TX.stl

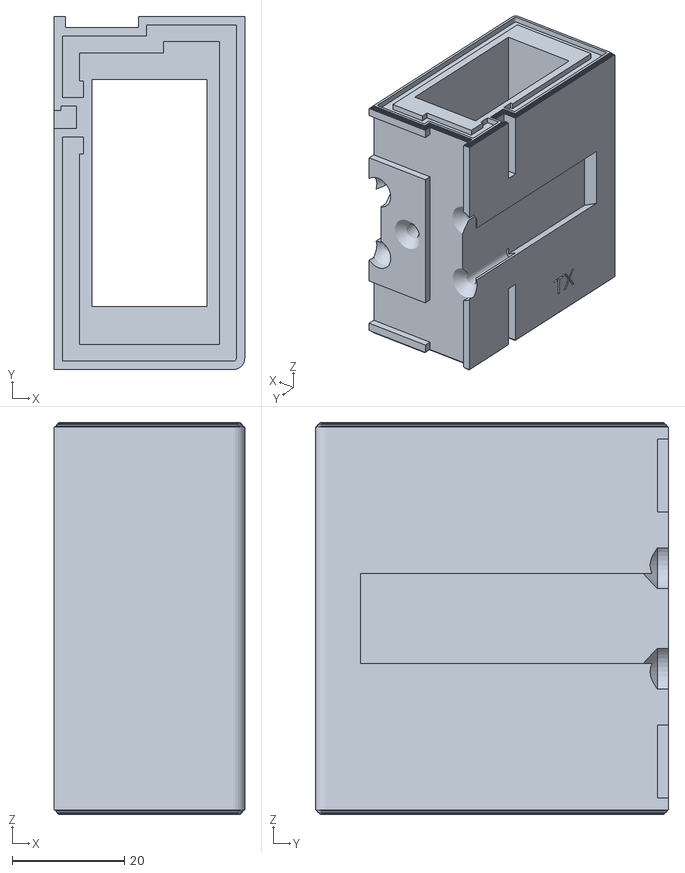
[picture p98: CAD file, 2026-10-17]
cad/stl/home-1800x1500-2bay/TX.stl
34.0 x 63.0 x 70.0
