aleesposito85/openwindow/cad/stl/my-window/GF.stl

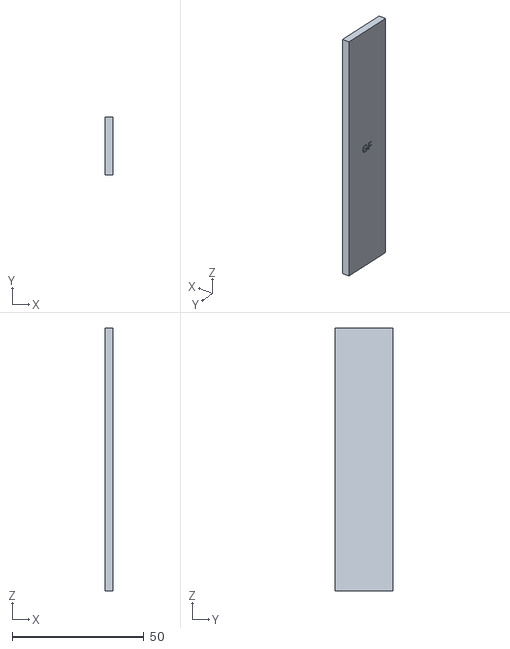
[picture p99: CAD file, 2026-10-17]
cad/stl/my-window/GF.stl
3.00 x 22.0 x 100.0
