aleesposito85/openwindow/cad/stl/bench-600/SV.stl

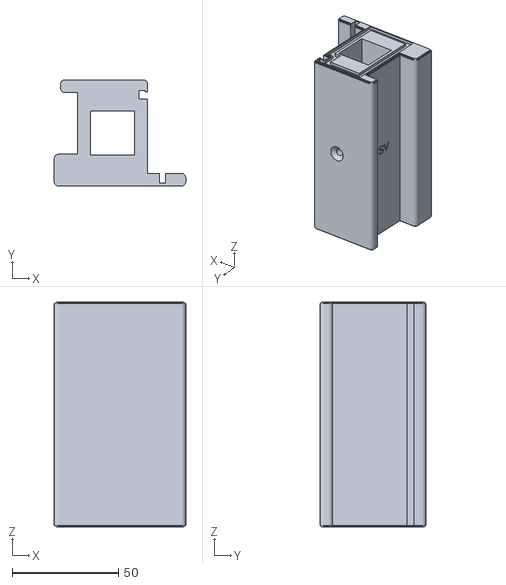
[picture p100: CAD file, 2026-10-17]
cad/stl/bench-600/SV.stl
62.0 x 50.0 x 106.0
