aleesposito85/openwindow/cad/stl/my-window/BSV.stl

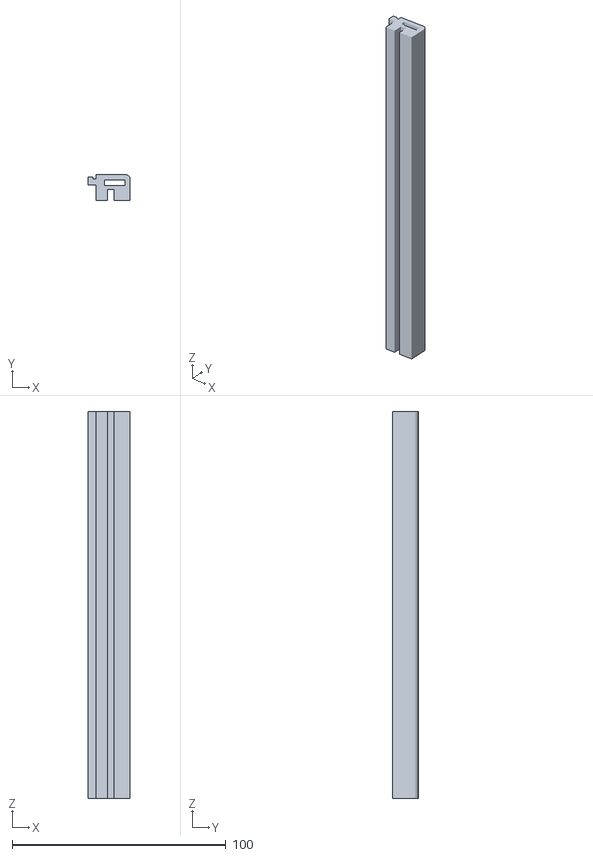
[picture p101: CAD file, 2026-10-17]
cad/stl/my-window/BSV.stl
19.8 x 12.0 x 181.0
