aleesposito85/openwindow/cad/stl/bench-600/SH.stl

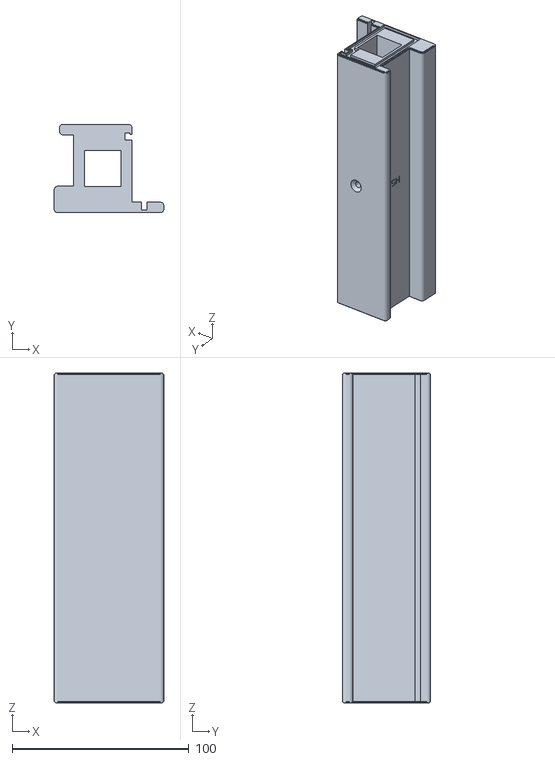
[picture p102: CAD file, 2026-10-17]
cad/stl/bench-600/SH.stl
62.0 x 50.0 x 186.5
