aleesposito85/openwindow/cad/stl/my-window/BFH.stl

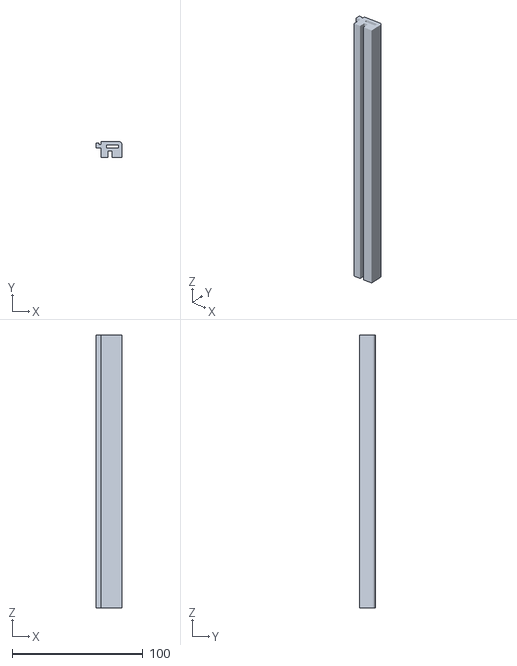
[picture p103: CAD file, 2026-10-17]
cad/stl/my-window/BFH.stl
19.8 x 12.0 x 208.8
