aleesposito85/openwindow/cad/stl/bench-600/TE.stl

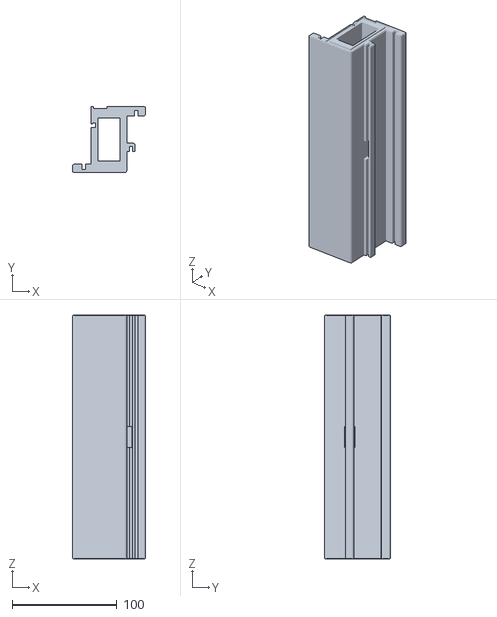
[picture p104: CAD file, 2026-10-17]
cad/stl/bench-600/TE.stl
70.0 x 63.0 x 232.5
