aleesposito85/openwindow/cad/stl/my-window/AFH.stl

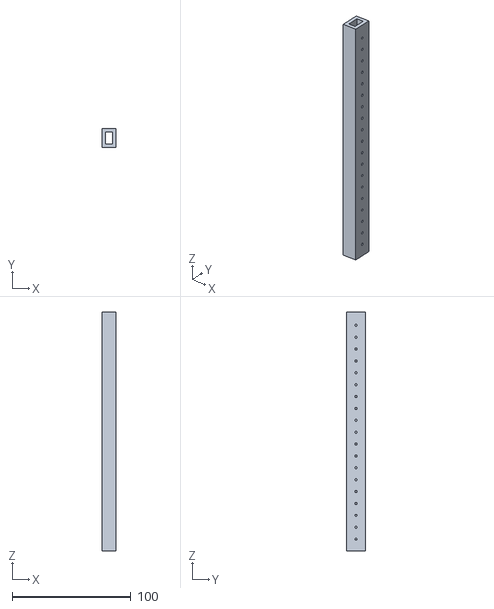
[picture p106: CAD file, 2026-10-17]
cad/stl/my-window/AFH.stl
12.0 x 16.0 x 201.2
