aleesposito85/openwindow/cad/stl/bench-600/SBE.stl

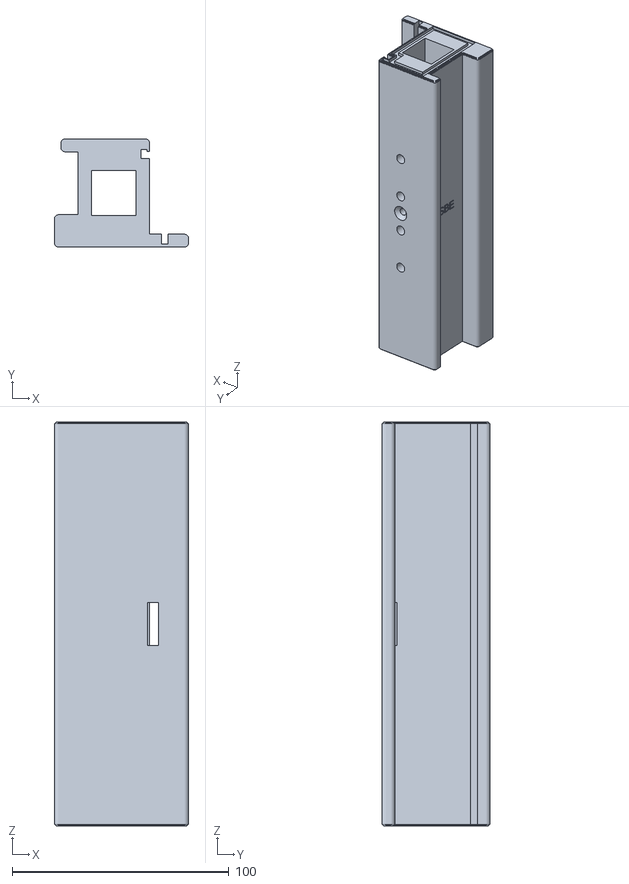
[picture p107: CAD file, 2026-10-17]
cad/stl/bench-600/SBE.stl
62.0 x 50.0 x 186.5
