aleesposito85/openwindow/cad/stl/bench-600/BSV.stl

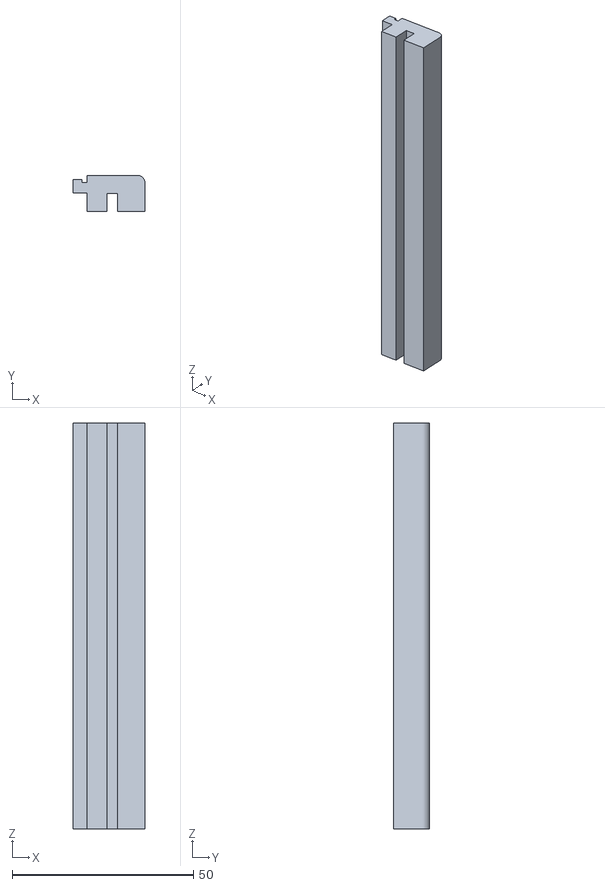
[picture p108: CAD file, 2026-10-17]
cad/stl/bench-600/BSV.stl
19.8 x 10.0 x 112.0
