aleesposito85/openwindow/cad/stl/my-window/JU.stl

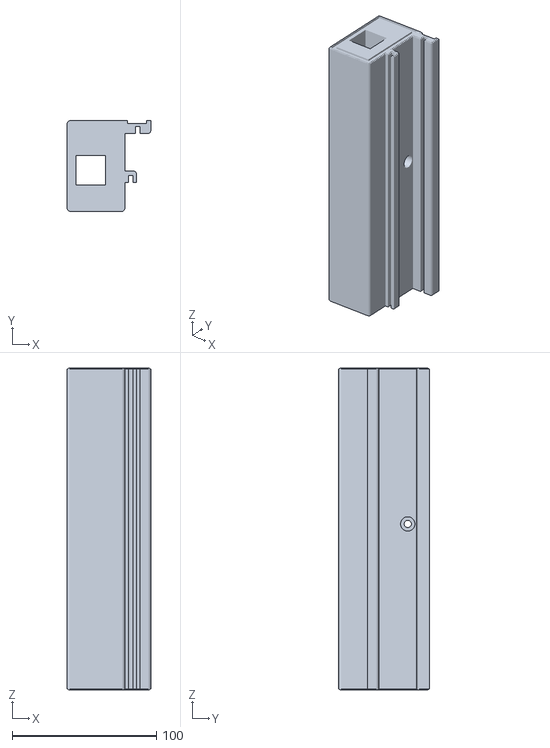
[picture p109: CAD file, 2026-10-17]
cad/stl/my-window/JU.stl
58.0 x 63.0 x 223.5
