aleesposito85/openwindow/cad/generated/layout.scad

NAME = "bench-600";
W = 584.0;
H = 584.0;
TRANSOM_C = 291.0;
AWNING_H = 200.0;
SASH = [478.0, 210.0];
SCREEN = [524.0, 290.0];
FIXED_GLASS = [498, 228];
SASH_GLASS_DIMS = [406, 138];
GLAZING = "acrylic";
SEG_HEAD = 232.5;
N_HEAD = 2;
SEG_SILL = 232.5;
N_SILL = 2;
SEG_JAMB_LOWER = 196.0;
N_JAMB_LOWER = 1;
SEG_JAMB_UPPER = 198.0;
N_JAMB_UPPER = 1;
SEG_TRANSOM = 232.5;
N_TRANSOM = 2;
SEG_SASH_HORIZONTAL = 186.5;
N_SASH_HORIZONTAL = 2;
SEG_SASH_VERTICAL = 106.0;
N_SASH_VERTICAL = 1;
SEG_SCREEN_HORIZONTAL = 232.0;
N_SCREEN_HORIZONTAL = 2;
SEG_SCREEN_VERTICAL = 230.0;
N_SCREEN_VERTICAL = 1;
