aleesposito85/openwindow/cad/tests/smoke_test.scad

include <../generated/dims.scad>
assert(is_num(MAX_SEG) && MAX_SEG > 0, "dims.scad not generated from cad/dims.json");
echo("smoke ok");
