aleesposito85/openwindow/cad/generated/parts/AC.scad

use <../../parts/acrylic_spacer.scad>
acrylic_spacer_corner("AC");
