aleesposito85/openwindow/cad/generated/parts/AFH.scad

use <../../parts/acrylic_spacer.scad>
acrylic_spacer(237.0, "AFH");
