aleesposito85/openwindow/cad/generated/parts/AFV.scad

use <../../parts/acrylic_spacer.scad>
acrylic_spacer(204.0, "AFV");
