aleesposito85/openwindow/cad/generated/parts/ASH.scad

use <../../parts/acrylic_spacer.scad>
acrylic_spacer(191.0, "ASH");
