aleesposito85/openwindow/cad/generated/parts/ASV.scad

use <../../parts/acrylic_spacer.scad>
acrylic_spacer(114.0, "ASV");
