aleesposito85/openwindow/cad/generated/parts/BFH.scad

use <../../parts/bead.scad>
bead("acrylic", 168.0, "BFH");
