aleesposito85/openwindow/cad/generated/parts/BFV.scad

use <../../parts/bead.scad>
bead("acrylic", 202.0, "BFV");
