aleesposito85/openwindow/cad/generated/parts/BSH.scad

use <../../parts/bead.scad>
bead("acrylic", 206.0, "BSH");
