aleesposito85/openwindow/cad/generated/parts/BSV.scad

use <../../parts/bead.scad>
bead("acrylic", 112.0, "BSV");
