aleesposito85/openwindow/cad/generated/parts/CH.scad

use <../../parts/corner_block.scad>
corner_block("sash_rebate", "sash_rebate", "CH");
