aleesposito85/openwindow/cad/generated/parts/CMB.scad

use <../../parts/cam_lock.scad>
cam_base("CMB");
