aleesposito85/openwindow/cad/generated/parts/CMH.scad

use <../../parts/cam_lock.scad>
cam_handle("CMH");
