aleesposito85/openwindow/cad/generated/parts/CN.scad

use <../../parts/corner_block.scad>
corner_block("screen", "screen", "CN");
