aleesposito85/openwindow/cad/generated/parts/CS.scad

use <../../parts/corner_block.scad>
corner_block("sash", "sash", "CS");
