aleesposito85/openwindow/cad/generated/parts/CSL.scad

use <../../parts/corner_block.scad>
corner_block("sill", "glazing", "CSL");
