aleesposito85/openwindow/cad/generated/parts/CSR.scad

use <../../parts/corner_block.scad>
corner_block("sill", "glazing", "CSR", mirrored=true);
