aleesposito85/openwindow/cad/generated/parts/GF.scad

use <../../parts/setting_block.scad>
setting_block("GF");
