aleesposito85/openwindow/cad/generated/parts/GW.scad

use <../../parts/setting_block.scad>
setting_block("GW", wedge=true);
