aleesposito85/openwindow/cad/generated/parts/H.scad

use <../../parts/frame_segment.scad>
frame_segment("sash_rebate", 232.5, "H", bosses=true);
