aleesposito85/openwindow/cad/generated/parts/HG.scad

use <../../parts/screen_hinge.scad>
screen_hinge("HG");
