aleesposito85/openwindow/cad/generated/parts/HS.scad

use <../../parts/screen_hinge.scad>
screen_leaf("HS");
