aleesposito85/openwindow/cad/generated/parts/JL.scad

use <../../parts/frame_segment.scad>
frame_segment("glazing", 196.0, "JL");
