aleesposito85/openwindow/cad/generated/parts/JN.scad

use <../../parts/jamb_node.scad>
jamb_node("JN");
