aleesposito85/openwindow/cad/generated/parts/JU.scad

use <../../parts/frame_segment.scad>
frame_segment("sash_rebate", 198.0, "JU");
