aleesposito85/openwindow/cad/generated/parts/KP.scad

use <../../parts/cam_lock.scad>
cam_keeper("KP");
