aleesposito85/openwindow/cad/generated/parts/NH.scad

use <../../parts/frame_segment.scad>
frame_segment("screen", 232.0, "NH");
