aleesposito85/openwindow/cad/generated/parts/NS.scad

use <../../parts/sill_nose.scad>
sill_nose(182.67, "NS");
