aleesposito85/openwindow/cad/generated/parts/NV.scad

use <../../parts/frame_segment.scad>
frame_segment("screen", 230.0, "NV");
