aleesposito85/openwindow/cad/generated/parts/SBE.scad

use <../../parts/frame_segment.scad>
frame_segment("sash", 186.5, "SBE", weep=true, bosses=true, boss_dz=23.0);
