aleesposito85/openwindow/cad/generated/parts/SH.scad

use <../../parts/frame_segment.scad>
frame_segment("sash", 186.5, "SH");
