aleesposito85/openwindow/cad/generated/parts/SV.scad

use <../../parts/frame_segment.scad>
frame_segment("sash", 106.0, "SV");
