aleesposito85/openwindow/cad/generated/parts/SW.scad

use <../../parts/frame_segment.scad>
frame_segment("sill", 232.5, "SW", weep=true);
