aleesposito85/openwindow/cad/generated/parts/TC.scad

use <../../parts/test_coupon.scad>
test_coupon("TC");
