aleesposito85/openwindow/(list of files, cad)

Other CAD files:
cad/stl/home-1800x1500/T.stl
cad/stl/bench-600/CSL.stl
cad/stl/home-1800x1500/NH.stl
cad/stl/my-window/CSR.stl
cad/stl/home-1800x1500-2bay/CSL.stl
cad/stl/home-1800x1500/TSL.stl
cad/stl/my-window/T.stl
cad/stl/home-1800x1500-2bay/JN.stl
cad/stl/my-window/H.stl
cad/stl/home-1800x1500/SBE.stl
cad/stl/bench-600/JN.stl
cad/stl/my-window/SW.stl
cad/stl/home-1800x1500-2bay/SW.stl
cad/stl/bench-600/AFH.stl
cad/stl/my-window/SBE.stl
cad/stl/bench-600/BSH.stl
cad/stl/home-1800x1500-2bay/T.stl
cad/stl/my-window/MSH.stl
cad/stl/home-1800x1500/SW.stl
cad/stl/home-1800x1500/JN.stl
cad/stl/my-window/HN.stl
cad/stl/home-1800x1500-2bay/S.stl
cad/stl/my-window/MST.stl
cad/stl/bench-600/TSL.stl
cad/stl/home-1800x1500/SH.stl
cad/stl/my-window/JL.stl
cad/stl/home-1800x1500/CSL.stl
cad/stl/home-1800x1500-2bay/SBE.stl
cad/stl/my-window/SV.stl
cad/stl/home-1800x1500-2bay/BFH.stl
cad/stl/home-1800x1500-2bay/MSH.stl
cad/stl/home-1800x1500/BFH.stl
cad/stl/my-window/MU.stl
cad/stl/home-1800x1500-2bay/H.stl
cad/stl/my-window/SH.stl
cad/stl/bench-600/AFV.stl
cad/stl/home-1800x1500-2bay/ML.stl
cad/stl/my-window/CSL.stl
cad/stl/home-1800x1500-2bay/TSL.stl
cad/stl/my-window/JN.stl
cad/parts/setting_block.scad
cad/assembly.scad
cad/generated/dims.scad
cad/parts/bead.scad
cad/parts/cross_node.scad
cad/parts/frame_node.scad
cad/parts/frame_segment.scad
cad/parts/mullion_shoe.scad
cad/parts/screen_hinge.scad
cad/parts/sill_nose.scad
cad/parts/test_coupon.scad
cad/parts/weep_cap.scad
cad/tests/fit_view.scad
cad/tests/lock_view.scad
cad/tests/mullion_sheet.scad
cad/tests/mullion_test.scad
cad/tests/profiles_sheet.scad
cad/generated/parts/TE.scad
cad/generated/parts/TSL.scad
cad/generated/parts/TSR.scad
cad/generated/parts/WC.scad
cad/stl/home-1800x1500-2bay/SB.stl
cad/stl/home-1800x1500-2bay/SH.stl
cad/stl/home-1800x1500-2bay/SN.stl
cad/stl/my-window/BFV.stl
cad/stl/my-window/BSH.stl
cad/stl/my-window/CH.stl
cad/stl/my-window/MSL.stl
cad/stl/my-window/S.stl
cad/stl/my-window/TSL.stl
