aleesposito85/openwindow/docs/img/deck/build-2.png

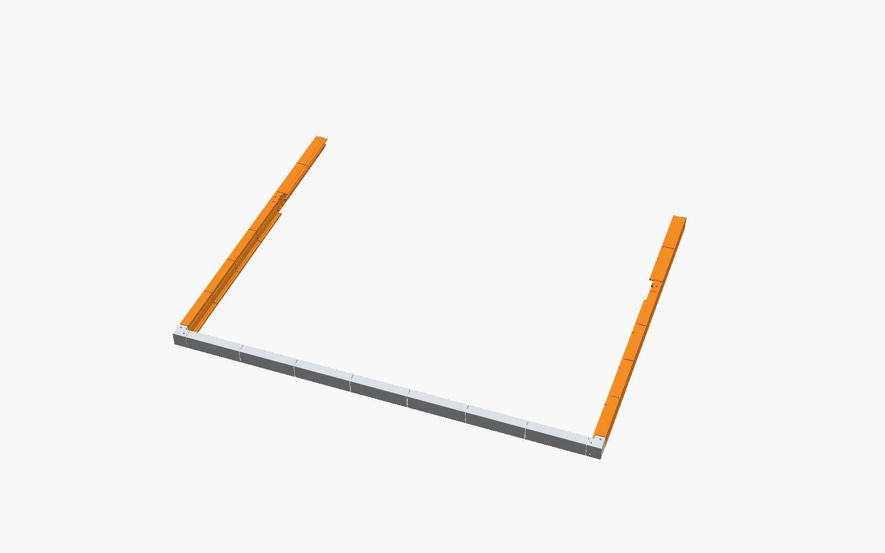
docs/img/deck/build-2.png
