aleesposito85/openwindow/docs/img/deck/build-3.png

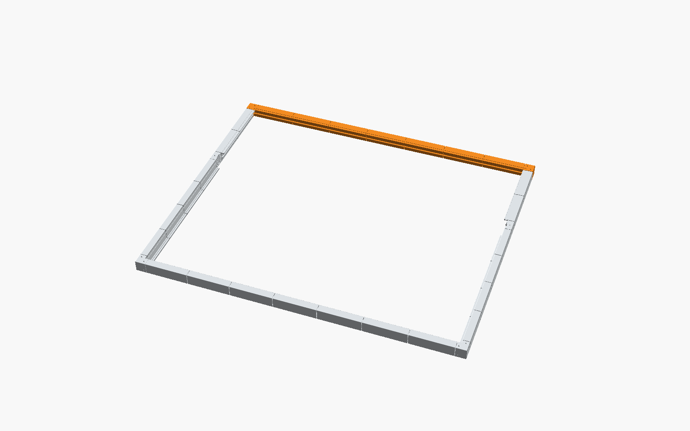
docs/img/deck/build-3.png
