aleesposito85/openwindow/docs/img/deck/build-4.png

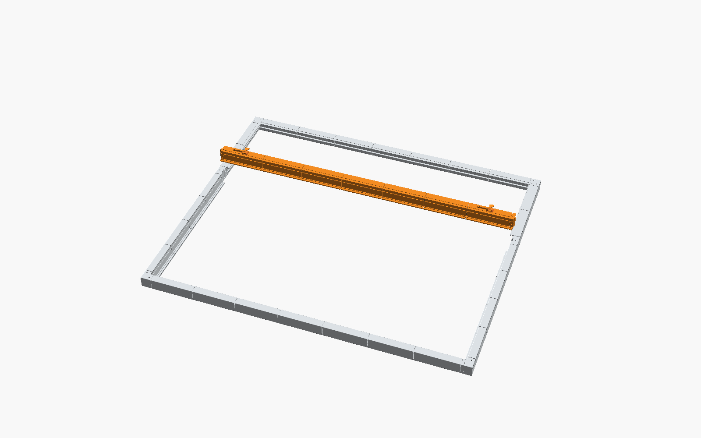
docs/img/deck/build-4.png
