aleesposito85/openwindow/docs/img/deck/build-6.png

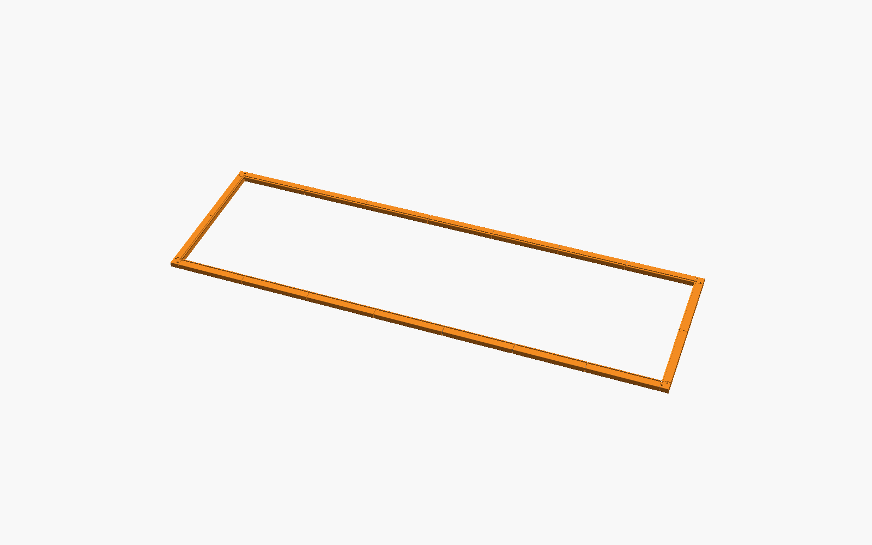
docs/img/deck/build-6.png
